Oru-star/Doomsday-deck/Asstets/cooler-40x40x10-1.snapshot.2/untitled.66.jpg

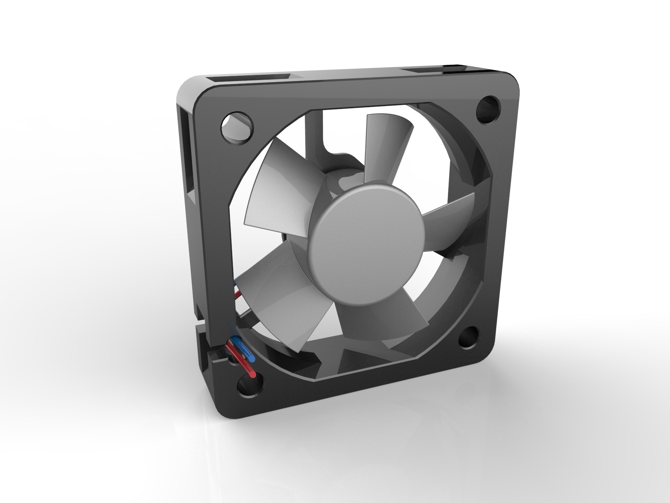
Asstets/cooler-40x40x10-1.snapshot.2/untitled.66.jpg
