Oru-star/Doomsday-deck/Asstets/cooler-40x40x10-1.snapshot.2/untitled.95.jpg

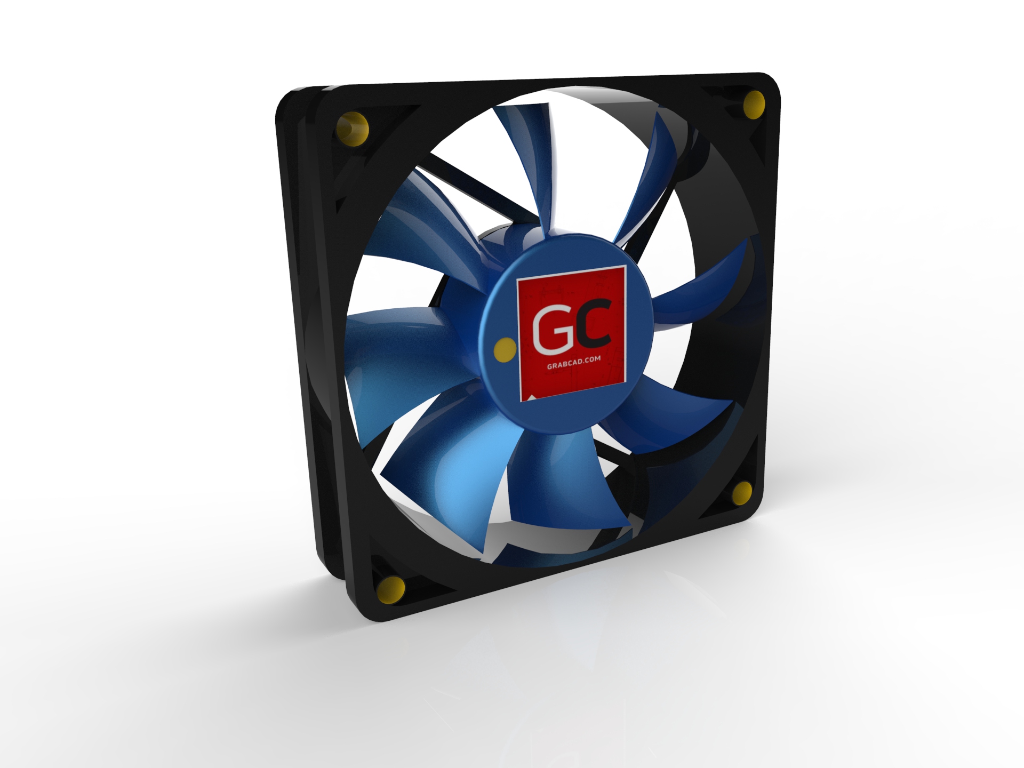
Asstets/cooler-40x40x10-1.snapshot.2/untitled.95.jpg
