Oru-star/Doomsday-deck/Asstets/pin-header-female-2-20-2-54mm-1.snapshot.1/pin header 2x20 2.54mm screen shot.png

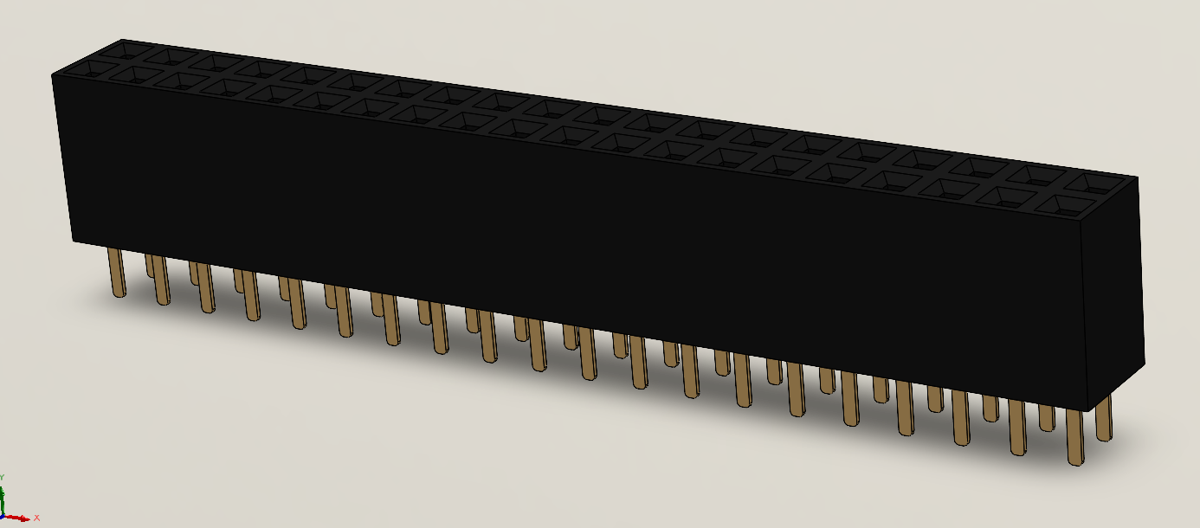
Asstets/pin-header-female-2-20-2-54mm-1.snapshot.1/pin header 2x20 2.54mm screen shot.png
