Oru-star/Doomsday-deck/Asstets/rtl-sdr-ver-3-1.snapshot.8/RTL_SDR-V3_bottom.png

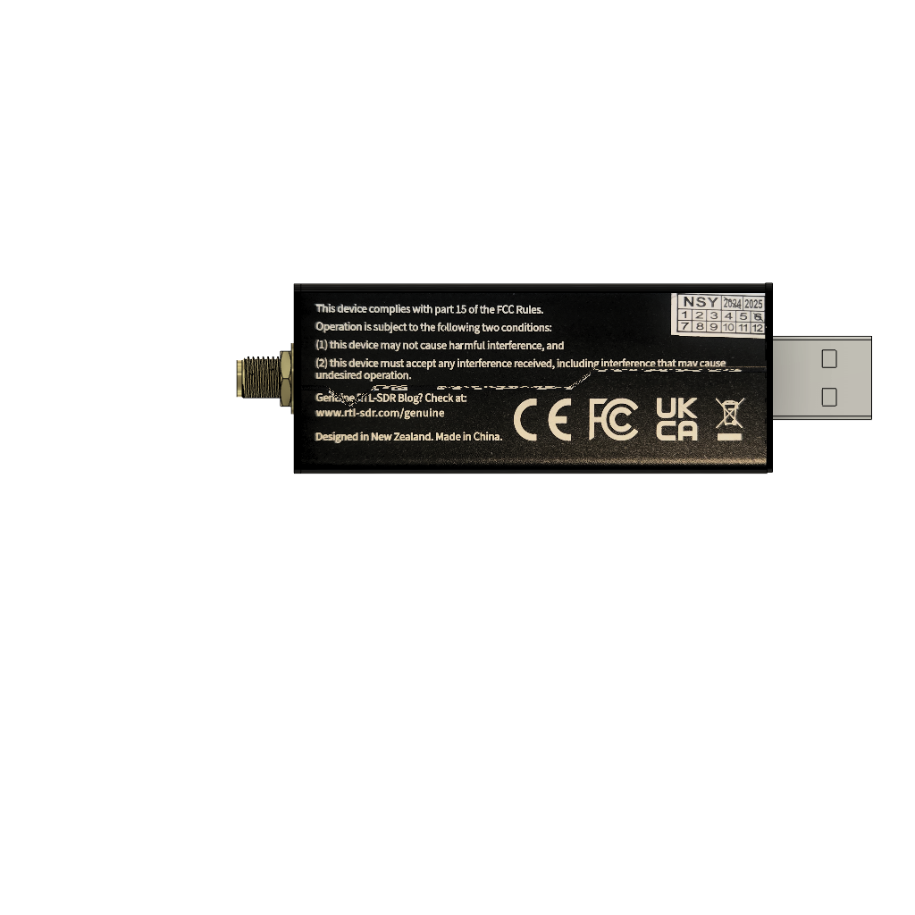
Asstets/rtl-sdr-ver-3-1.snapshot.8/RTL_SDR-V3_bottom.png
