Oru-star/Doomsday-deck/Asstets/rtl-sdr-ver-3-1.snapshot.8/RTL_SDR-V3_left.png

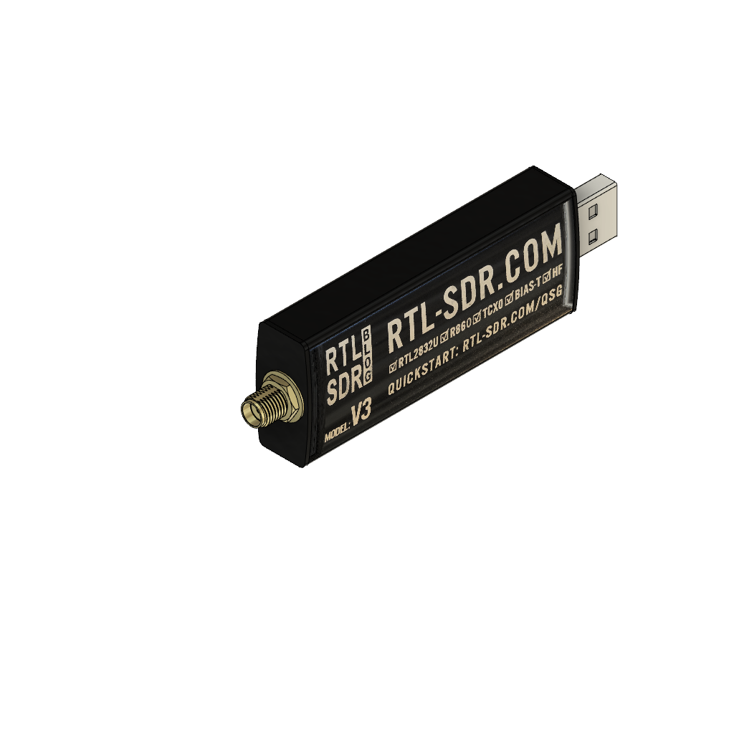
Asstets/rtl-sdr-ver-3-1.snapshot.8/RTL_SDR-V3_left.png
