Oru-star/Doomsday-deck/Asstets/rtl-sdr-ver-3-1.snapshot.8/RTL_SDR_ortho.png

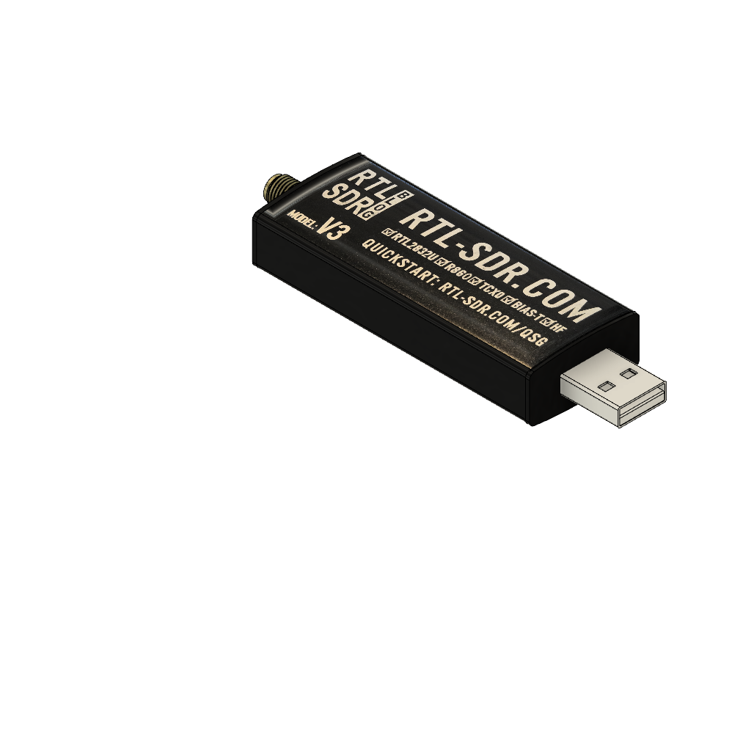
Asstets/rtl-sdr-ver-3-1.snapshot.8/RTL_SDR_ortho.png
