Oru-star/Doomsday-deck/Asstets/usb-typ-a-female-wuerth-629104190121-1.snapshot.1/USB_Type_A_-_Female_-_Würth___629104190121_2021-May-03_12-08-54PM-000_CustomizedView10317502424_png.png

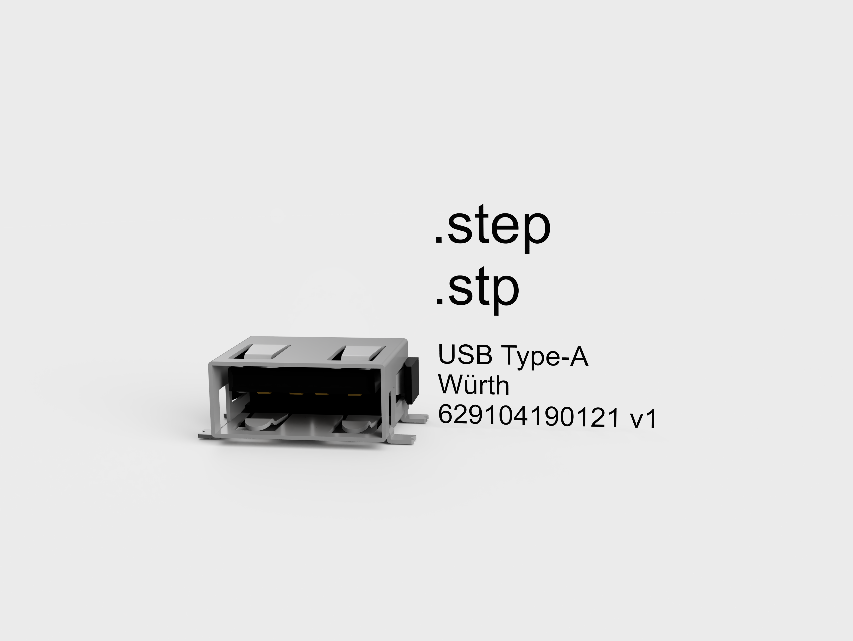
Asstets/usb-typ-a-female-wuerth-629104190121-1.snapshot.1/USB_Type_A_-_Female_-_Würth___629104190121_2021-May-03_12-08-54PM-000_CustomizedView10317502424_png.png
