Oru-star/Doomsday-deck/IMAGES/78b79957-672b-4fc0-9b4d-2bc85868780d.TIFF

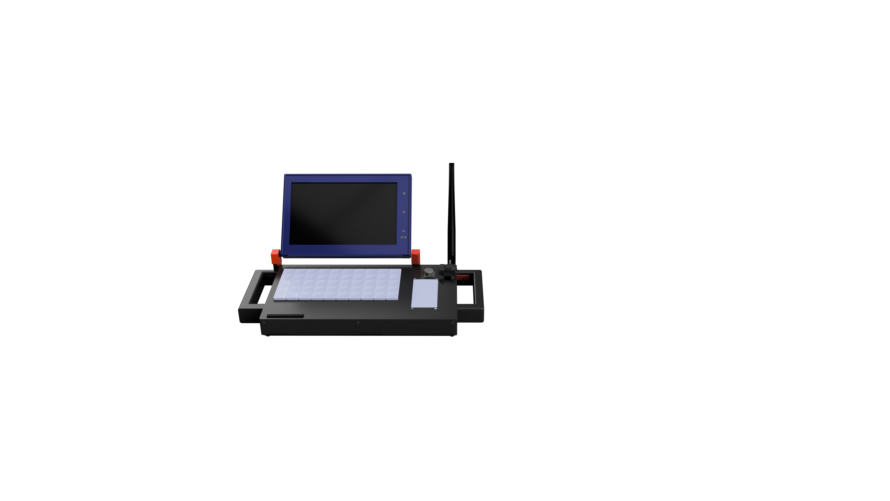
IMAGES/78b79957-672b-4fc0-9b4d-2bc85868780d.TIFF
