Oru-star/Doomsday-deck/IMAGES/BACK-RENDER.TIFF

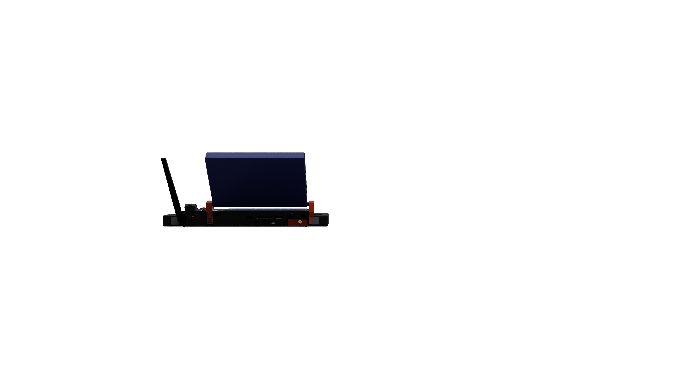
IMAGES/BACK-RENDER.TIFF
