Oru-star/Doomsday-deck/3Dprints for deck/Covers,hinge etc/Left speaker cover.stl

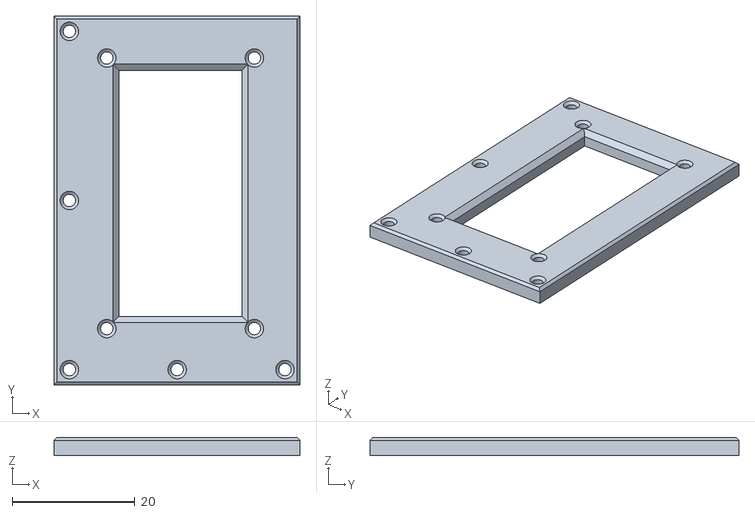
[picture p21: CAD file, 2026-11-02]
3Dprints for deck/Covers,hinge etc/Left speaker cover.stl
40.0 x 60.0 x 3.00
