Oru-star/Doomsday-deck/3Dprints for deck/MAIN DECK/Doomsday Deck-Top plate(Right).stl

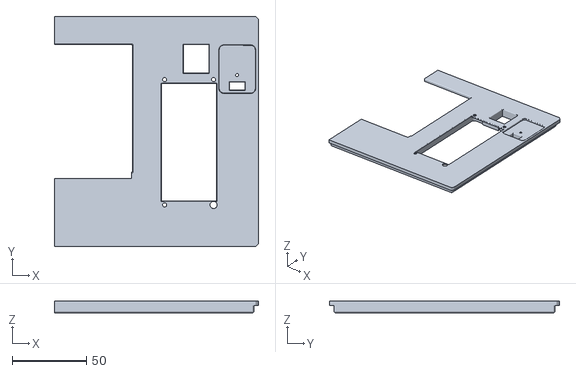
[picture p22: CAD file, 2026-11-02]
3Dprints for deck/MAIN DECK/Doomsday Deck-Top plate(Right).stl
137.5 x 155.0 x 8.00
