Oru-star/Doomsday-deck/3Dprints for deck/SCREEN PART/Bottom_bezzel.stl

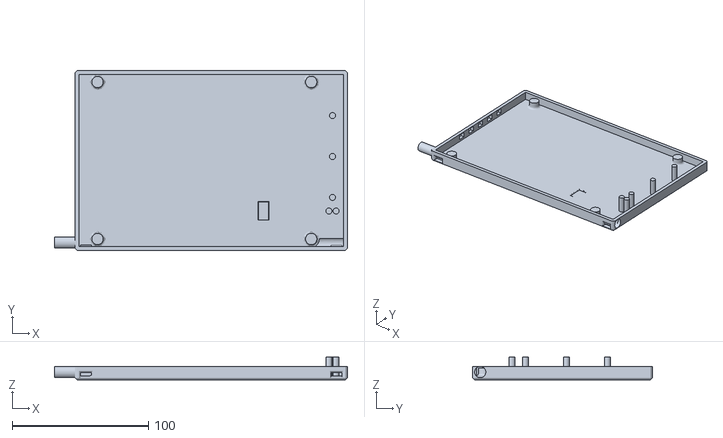
[picture p23: CAD file, 2026-11-02]
3Dprints for deck/SCREEN PART/Bottom_bezzel.stl
215.0 x 132.0 x 16.8
