Oru-star/Doomsday-deck/Asstets/antenna-868-mhz-5dbi-sma-1.snapshot.3/Antenna 868mhz 5dbi 45dg.step

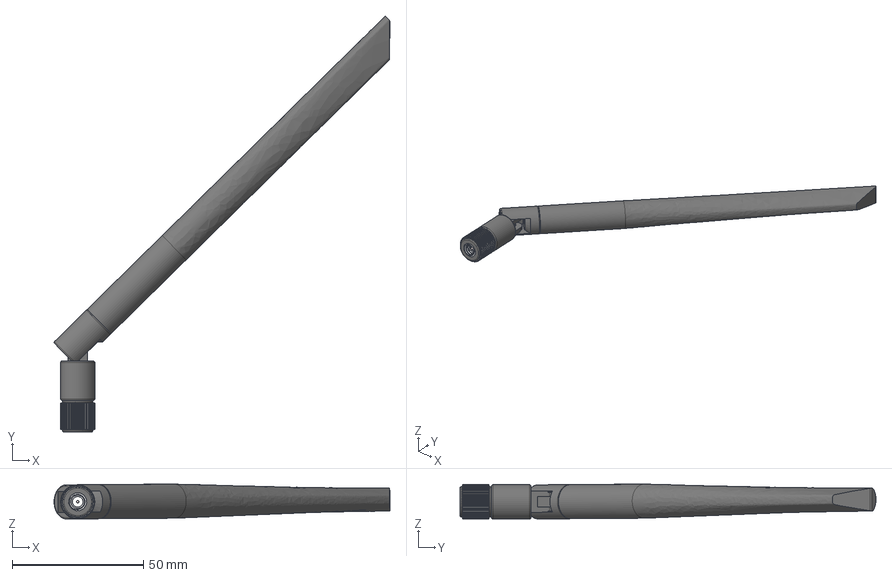
[picture p24: CAD file, 2026-10-02]
Asstets/antenna-868-mhz-5dbi-sma-1.snapshot.3/Antenna 868mhz 5dbi 45dg.step
127.7 x 158.2 x 13.3 mm
SMA sleeve
SMA
Sleeve yoke
emitter yoke
emitter tube
emitter cover
