Oru-star/Doomsday-deck/Asstets/cooler-40x40x10-1.snapshot.2/╨║╤â╨╗╨╡╤Ç 40╤à40╤à10.STEP

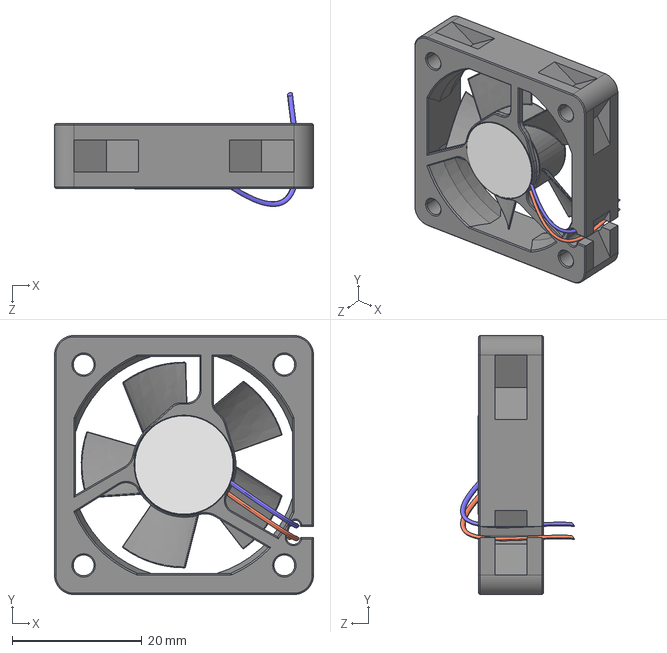
[picture p25: CAD file, 2026-10-10]
Asstets/cooler-40x40x10-1.snapshot.2/╨║╤â╨╗╨╡╤Ç 40╤à40╤à10.STEP
40.0 x 40.0 x 17.6 mm
корпус 40х40х10
вентилятор
