Oru-star/Doomsday-deck/Asstets/dxf/OPi ZERO 3W V1_2_BOT.dxf

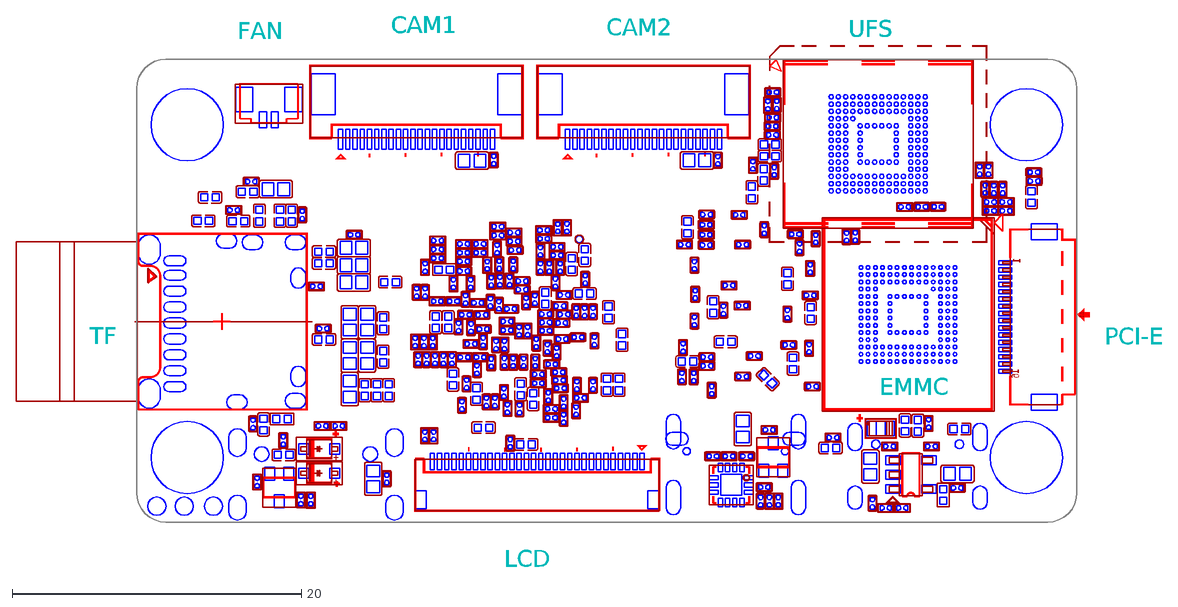
[picture p26: CAD file, 2026-09-23]
Asstets/dxf/OPi ZERO 3W V1_2_BOT.dxf
16
1
FAN
CAM2
CAM1
EMMC
UFS
PCI-E
LCD
TF
