Oru-star/Doomsday-deck/Asstets/Keyboard-Doomsdaydeck.step

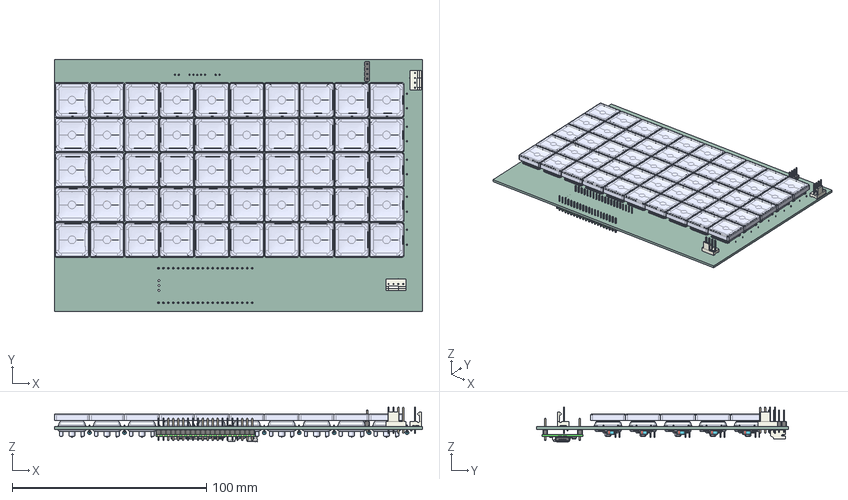
[picture p27: CAD file, 2026-11-02]
Asstets/Keyboard-Doomsdaydeck.step
189.5 x 130.0 x 17.9 mm
Fan_Pin_Header_Straight_1x04 x 2
PinHeader_1x04_P254mm_Vertical
D_DO-35_SOD27_P7.62mm_Horizontal x 50
JST_S2B_PH_K x 2
PinHeader_1x20_P2.54mm_Vertical.step
SMD Resistor, Configurable, Raspberry Pi Pico-R3_R7
U2, RT6150B-33GQW, Buck Boost Converter, Raspberry Pi Pico-R3
SMD Capacitor, Configurable, Raspberry Pi Pico-R3_C3
SMD Resistor, Configurable, Raspberry Pi Pico-R3_R14
SMD Capacitor, Configurable, Raspberry Pi Pico-R3_C12
SMD Resistor, Configurable, Raspberry Pi Pico-R3_R2
SMD Capacitor, Configurable, Raspberry Pi Pico-R3_C13
SMD Resistor, Configurable, Raspberry Pi Pico-R3_R12
U3, W25Q16JVUXIQ, Serial NOR Flash 16 Mbit, Raspberry Pi Pico-R3
SMD Resistor, Configurable, Raspberry Pi Pico-R3_R5
SMD Resistor, Configurable, Raspberry Pi Pico-R3_R1
MicroUSB Port, Raspberry Pi Pico-R3
X1, X12M000000S096, 12 Mhz Crystal Resonator, Raspberry Pi Pico-R3
SMD Capacitor, Configurable, Raspberry Pi Pico-R3_C2
SMD Resistor, Configurable, Raspberry Pi Pico-R3_R4
Q1, MOSFET, DMG1012T, Raspberry Pi Pico-R3
SMD Capacitor, Configurable, Raspberry Pi Pico-R3_C11
SMD Resistor, Configurable, Raspberry Pi Pico-R3_R6
RP2040 Microcontroller, Raspberry Pi Pico-R3
SMD Resistor, Configurable, Raspberry Pi Pico-R3_R9
D1, Diode, Schottky, Raspberry Pi Pico-R3
SMD Resistor, Configurable, Raspberry Pi Pico-R3_R3
SMD Capacitor, Configurable, Raspberry Pi Pico-R3_C8
SMD Capacitor, Configurable, Raspberry Pi Pico-R3_C6
SMD Capacitor, Configurable, Raspberry Pi Pico-R3_C17
SMD Capacitor, Configurable, Raspberry Pi Pico-R3_C16
SMD Capacitor, Configurable, Raspberry Pi Pico-R3_C7
SMD Resistor, Configurable, Raspberry Pi Pico-R3_R11
SMD Capacitor, Configurable, Raspberry Pi Pico-R3_C4
D2, QSME-C194, LED, Raspberry Pi Pico-R3
SMD Capacitor, Configurable, Raspberry Pi Pico-R3_C14
SMD Resistor, Configurable, Raspberry Pi Pico-R3_R8
SW1, Tact Switch, Raspberry Pi Pico-R3
SMD Capacitor, Configurable, Raspberry Pi Pico-R3_C9
SMD Resistor, Configurable, Raspberry Pi Pico-R3_R15
SMD Capacitor, Configurable, Raspberry Pi Pico-R3_C5
SMD Resistor, Configurable, Raspberry Pi Pico-R3_R13
SMD Resistor, Configurable, Raspberry Pi Pico-R3_R10
SMD Capacitor, Configurable, Raspberry Pi Pico-R3_C10
L1, Inductor, Raspberry Pi Pico-R3
PCB, Raspberry Pi Pico-R3
SMD Capacitor, Configurable, Raspberry Pi Pico-R3_C1
SMD Capacitor, Configurable, Raspberry Pi Pico-R3_C15
SMD Capacitor, Configurable, Raspberry Pi Pico-R3_C18
JST_S5B_PH_K
Key1B59_PCB
