Oru-star/Doomsday-deck/Asstets/LIB_USB2517I-JZX/USB2517I-JZX/3D/USB2517I-JZX.stp

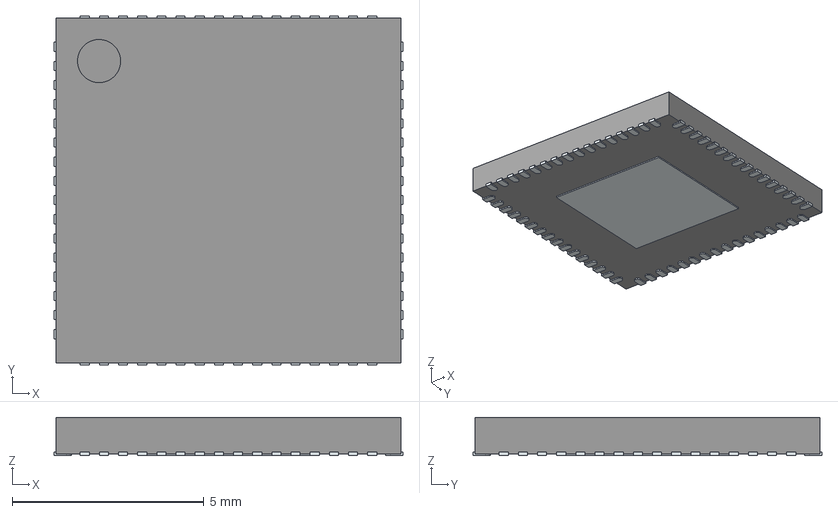
[picture p28: CAD file, 2026-09-23]
Asstets/LIB_USB2517I-JZX/USB2517I-JZX/3D/USB2517I-JZX.stp
9.10 x 9.10 x 1.00 mm
ThermalPin
PinsArrayLR
PinsArrayTB
