Oru-star/Doomsday-deck/Asstets/Model/CapTFT_V2.3mf

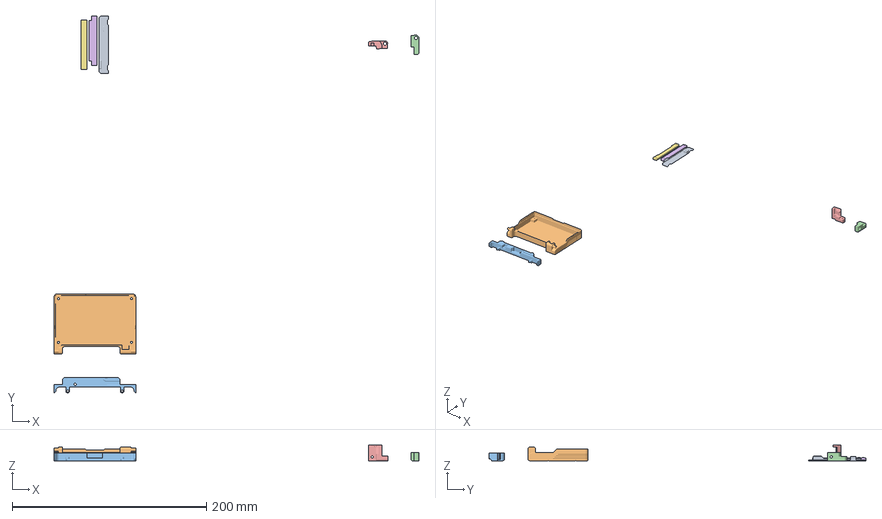
[picture p29: CAD file, 2026-10-02]
Asstets/Model/CapTFT_V2.3mf
375.2 x 387.8 x 16.0 mm
CaseC1.stl
CaseD1.stl
CaseS1.stl
CaseL1.stl
CaseR1.stl
CaseD3.stl
CaseD2.stl
