Oru-star/Doomsday-deck/Asstets/Model/STL/CaseS1.stl

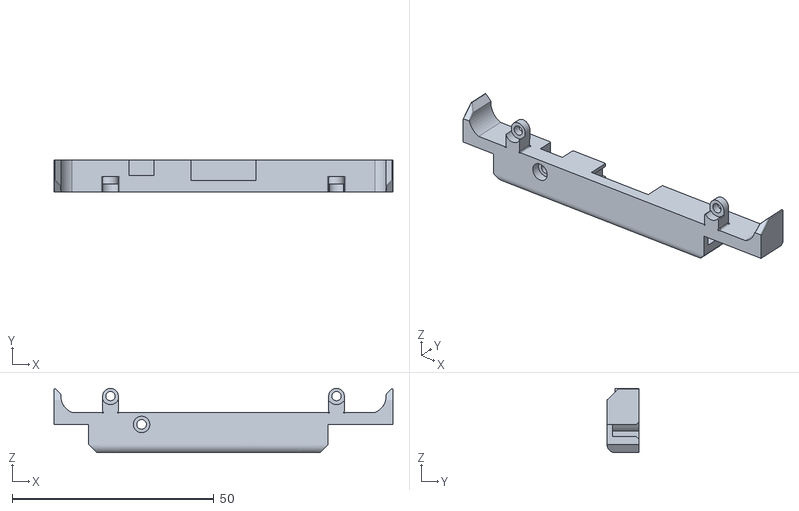
[picture p30: CAD file, 2026-10-02]
Asstets/Model/STL/CaseS1.stl
84.0 x 7.90 x 16.0
