Oru-star/Doomsday-deck/Asstets/pin-header-female-2-20-2-54mm-1.snapshot.1/Header 2x20 2.54mm.SLDPRT

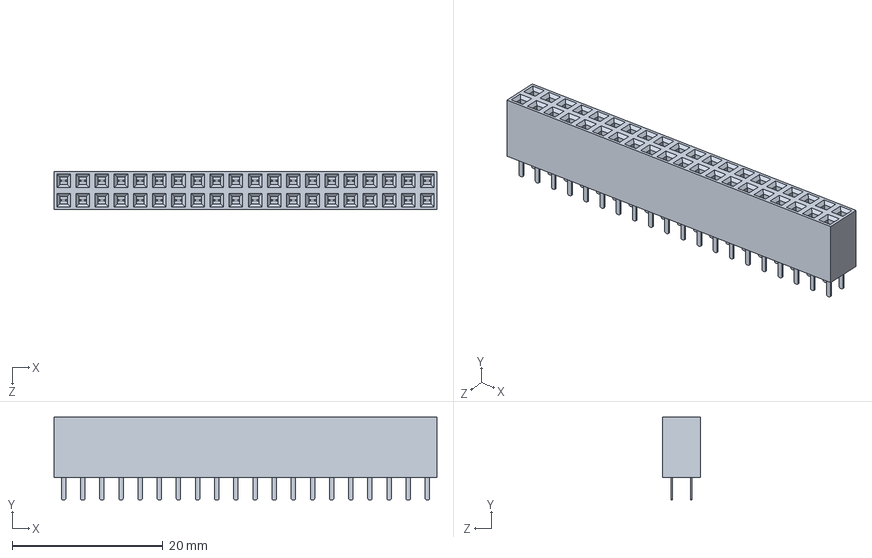
[picture p31: CAD file, 2026-10-10]
Asstets/pin-header-female-2-20-2-54mm-1.snapshot.1/Header 2x20 2.54mm.SLDPRT
50.8 x 11.0 x 5.08 mm
