Oru-star/Doomsday-deck/Asstets/rtl-sdr-ver-3-1.snapshot.8/RTL_SDR-V3.step

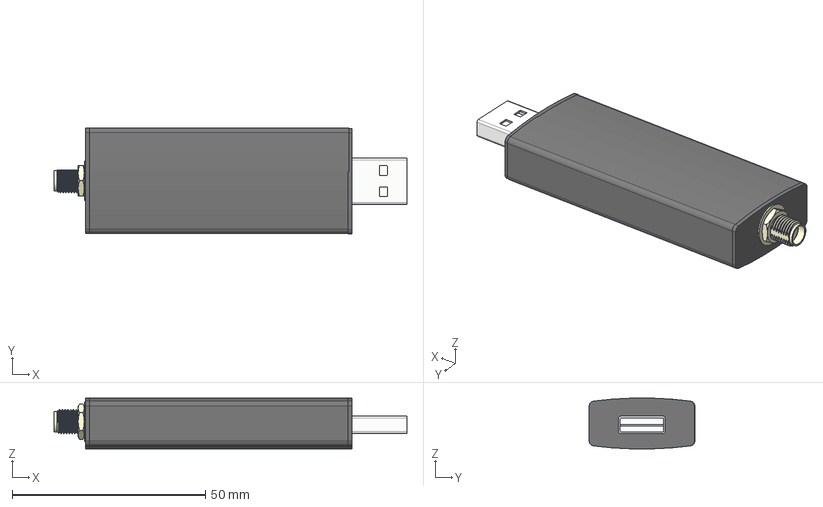
[picture p32: CAD file, 2026-09-23]
Asstets/rtl-sdr-ver-3-1.snapshot.8/RTL_SDR-V3.step
91.2 x 27.3 x 13.1 mm
main_body
face_sma
sma_jack
face_usb
