Oru-star/Doomsday-deck/Asstets/sma-antenna-connector-2.snapshot.3/Connector_Ass_Step.STEP

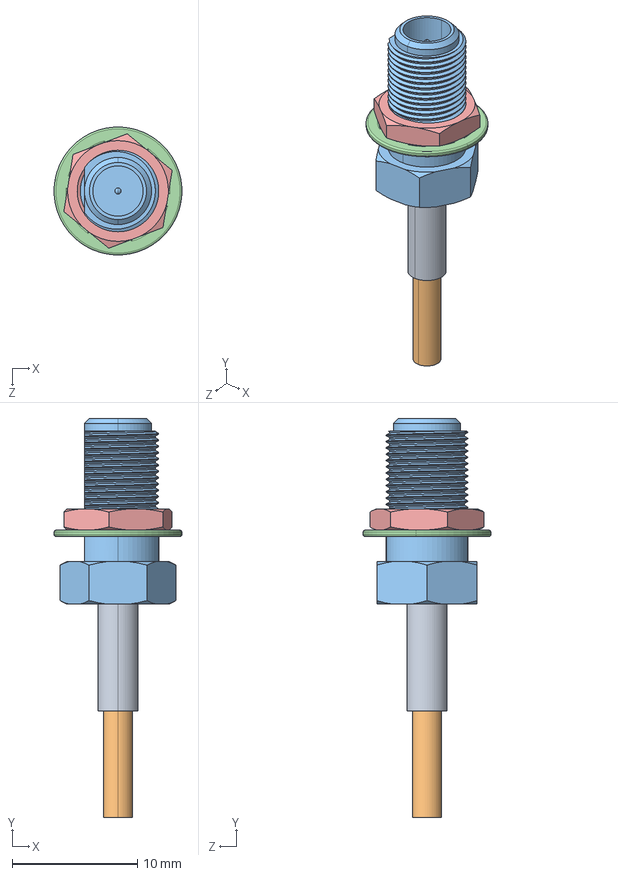
[picture p33: CAD file, 2026-10-02]
Asstets/sma-antenna-connector-2.snapshot.3/Connector_Ass_Step.STEP
10.2 x 31.8 x 10.2 mm
Connector_2
Washer
Nut
