Oru-star/Doomsday-deck/Asstets/usb-typ-a-female-wuerth-629104190121-1.snapshot.1/USB Type A - Female - Würth _ 629104190121.step

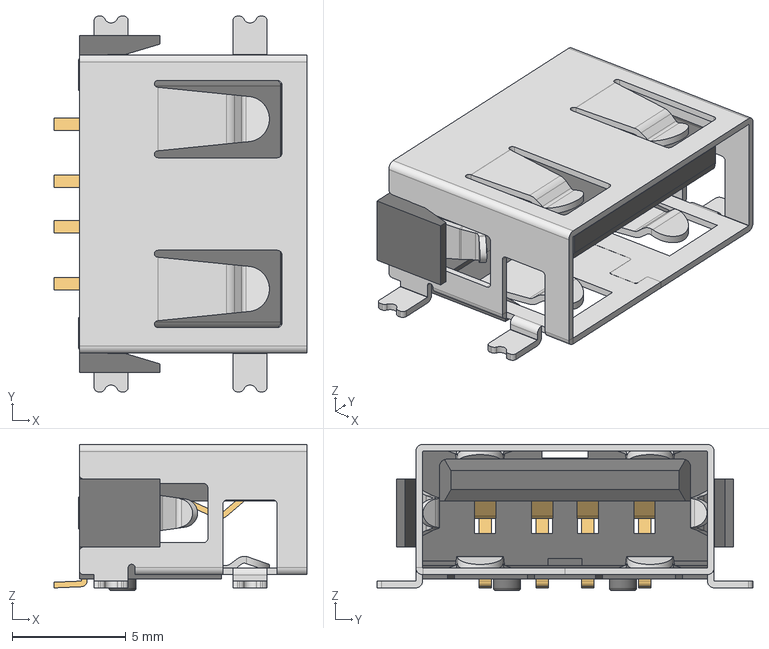
[picture p34: CAD file, 2026-09-26]
Asstets/usb-typ-a-female-wuerth-629104190121-1.snapshot.1/USB Type A - Female - Würth _ 629104190121.step
11.1 x 16.5 x 6.42 mm
