Oru-star/Doomsday-deck/carrier-orange pi zero 3w/step's n render's/Base-parts/RTL_COVER.step

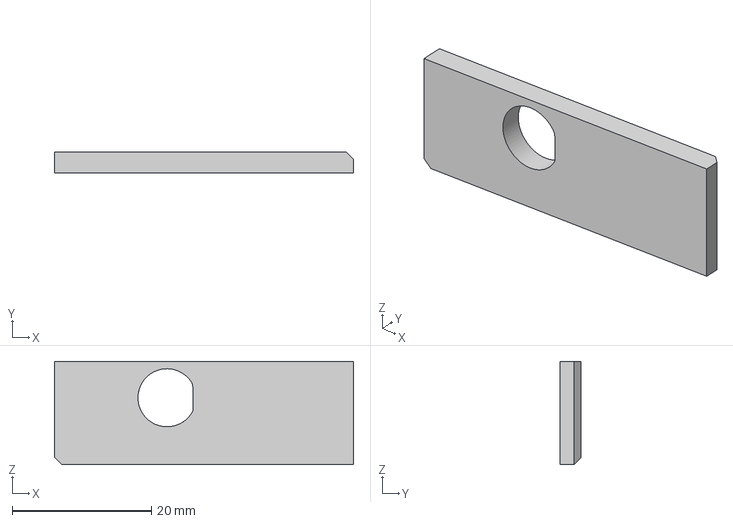
[picture p35: CAD file, 2026-10-10]
carrier-orange pi zero 3w/step's n render's/Base-parts/RTL_COVER.step
43.0 x 3.00 x 14.8 mm
