Oru-star/Doomsday-deck/PCB'S/KEYBOARD'S PCB/KEYBOARD ASSETS/kailh-low-profile-keycaps-1.snapshot.2/Kailh LP Keycap.SLDPRT

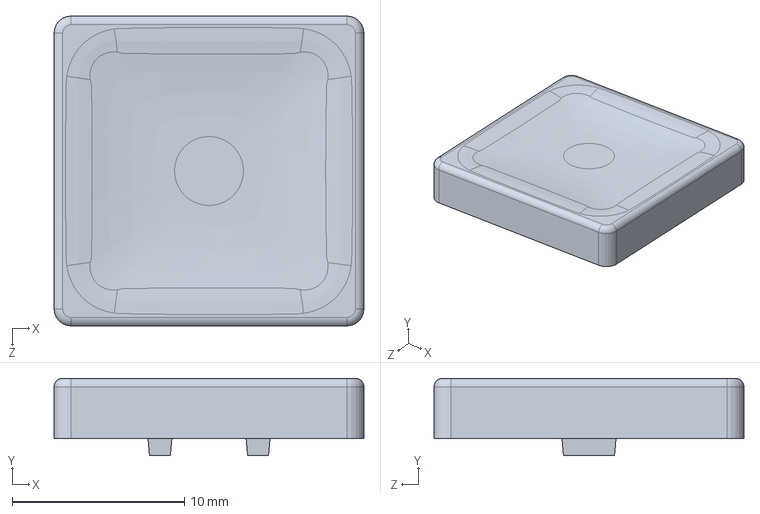
[picture p36: CAD file, 2026-09-23]
PCB'S/KEYBOARD'S PCB/KEYBOARD ASSETS/kailh-low-profile-keycaps-1.snapshot.2/Kailh LP Keycap.SLDPRT
18.0 x 4.50 x 18.0 mm
