Oru-star/Doomsday-deck/PCB'S/KEYBOARD'S PCB/KEYBOARD ASSETS/kailh-low-profile-keycaps-1.snapshot.2/KailhLP Choc Keycap STEP/1x1.75.STEP

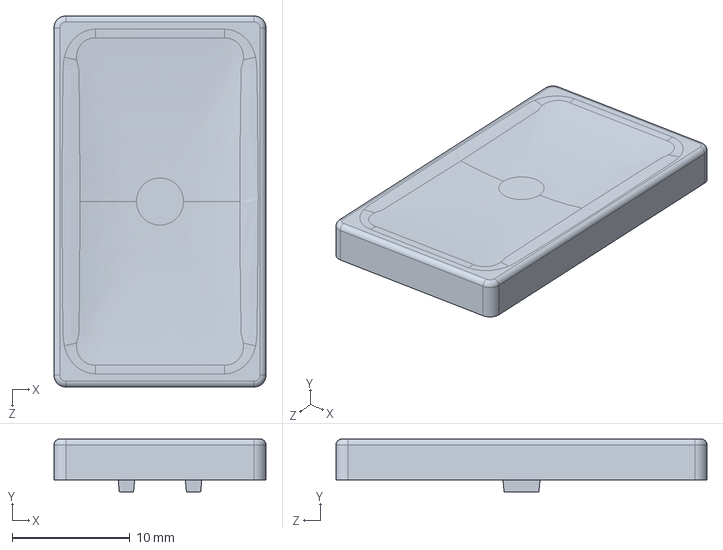
[picture p37: CAD file, 2026-09-23]
PCB'S/KEYBOARD'S PCB/KEYBOARD ASSETS/kailh-low-profile-keycaps-1.snapshot.2/KailhLP Choc Keycap STEP/1x1.75.STEP
18.0 x 4.50 x 31.5 mm
