Oru-star/Doomsday-deck/PCB'S/KEYBOARD'S PCB/KEYBOARD ASSETS/kailh-low-profile-mechanical-keyboard-switch-1.snapshot.1/Kailh LP Choc Burnt Orange.STEP

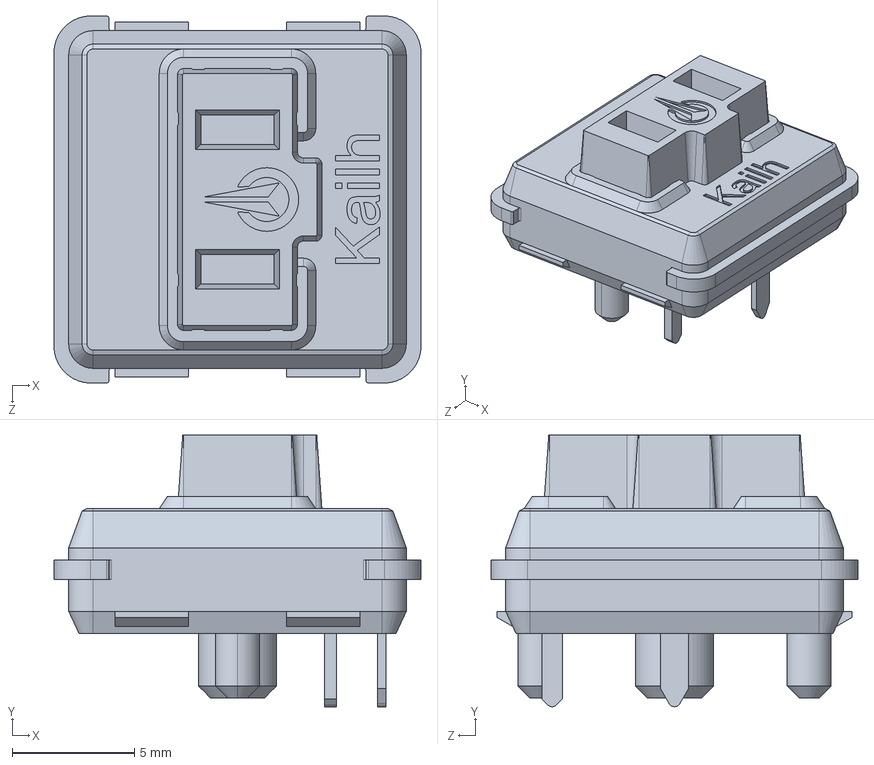
[picture p38: CAD file, 2026-09-23]
PCB'S/KEYBOARD'S PCB/KEYBOARD ASSETS/kailh-low-profile-mechanical-keyboard-switch-1.snapshot.1/Kailh LP Choc Burnt Orange.STEP
15.0 x 11.1 x 15.0 mm
