Oru-star/Doomsday-deck/PCB'S/KEYBOARD'S PCB/KEYBOARD ASSETS/seeed-studio-xiao-rp2040-3d-model/Seeed Studio XIAO RP2040 v26.step

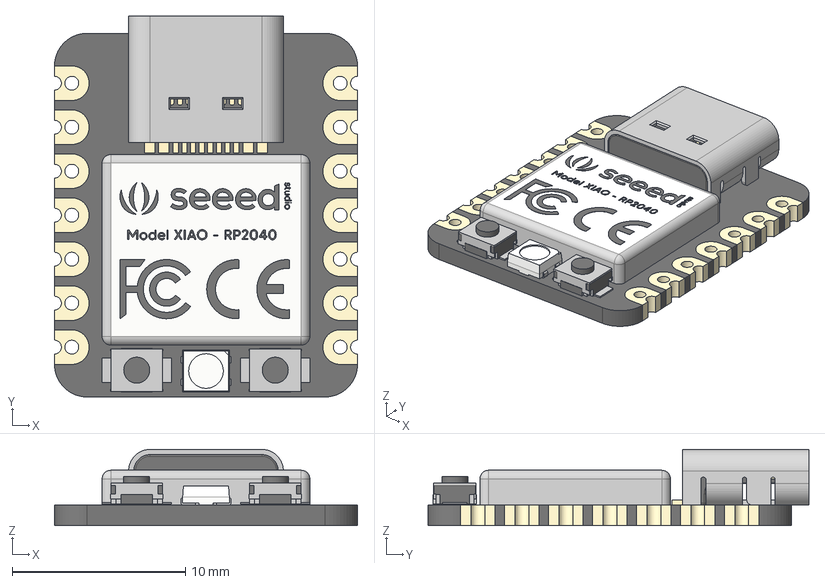
[picture p39: CAD file, 2026-09-23]
PCB'S/KEYBOARD'S PCB/KEYBOARD ASSETS/seeed-studio-xiao-rp2040-3d-model/Seeed Studio XIAO RP2040 v26.step
17.5 x 22.0 x 4.40 mm
type-c v2
smd_button v3
DOUT
DIN
VSS
VDD
smd_button v3(Mirror)
