Oru-star/Doomsday-deck/step's n render's/DECK-BASE/BASE.step

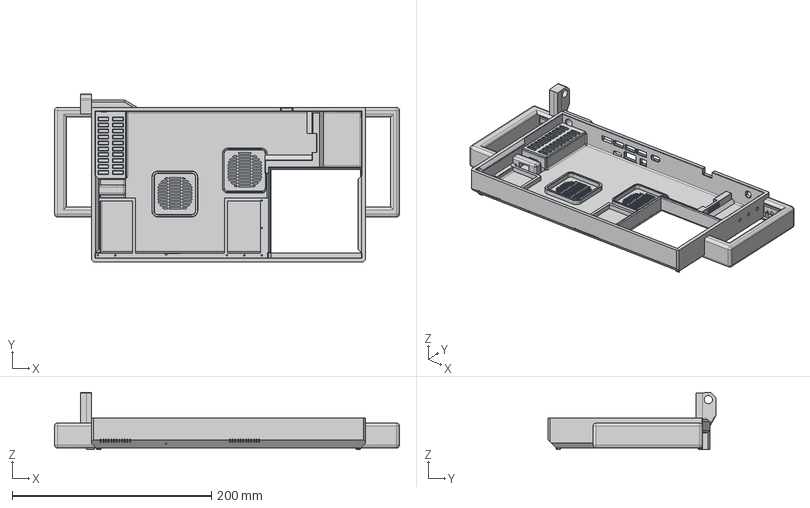
[picture p40: CAD file, 2026-10-10]
step's n render's/DECK-BASE/BASE.step
346.0 x 168.1 x 57.3 mm
