Oru-star/Doomsday-deck/step's n render's/DECK-TOP/TOP_PANNEL.step

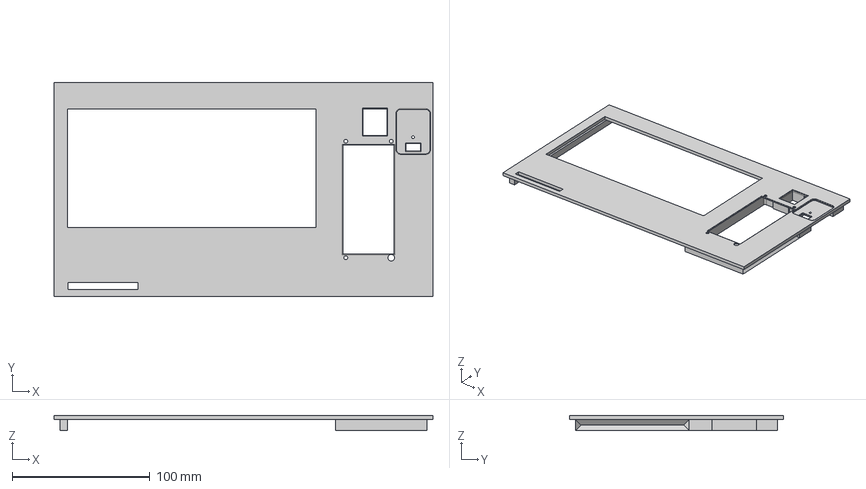
[picture p41: CAD file, 2026-10-10]
step's n render's/DECK-TOP/TOP_PANNEL.step
275.0 x 155.0 x 11.0 mm
