Oru-star/Doomsday-deck/step's n render's/DISPLAY-TOP/TOP_BEZZEL.step

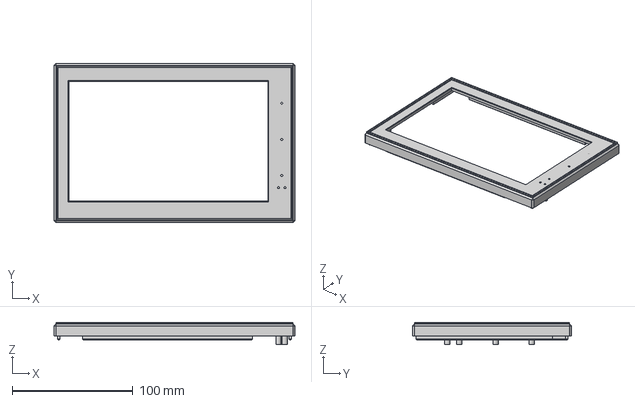
[picture p42: CAD file, 2026-10-10]
step's n render's/DISPLAY-TOP/TOP_BEZZEL.step
200.0 x 132.0 x 18.5 mm
