Oru-star/Doomsday-deck/3Dprints for deck/MAIN DECK/RIGHT_SIDE OF DECK.stl

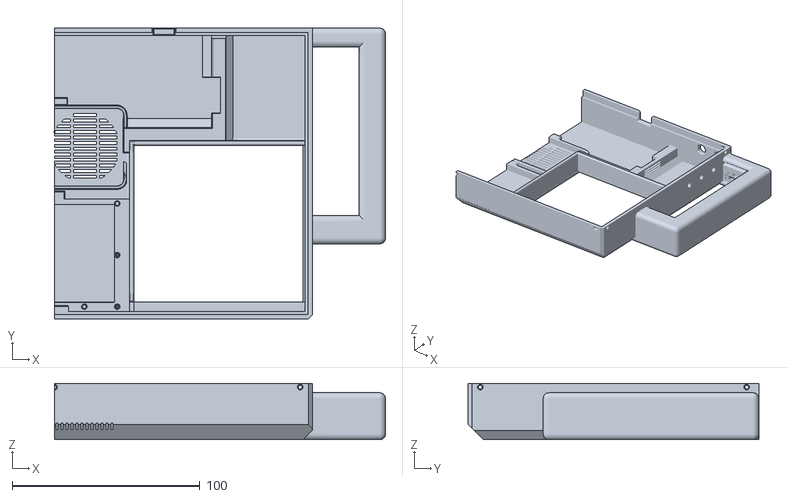
[picture p43: CAD file, 2026-11-02]
3Dprints for deck/MAIN DECK/RIGHT_SIDE OF DECK.stl
176.5 x 155.0 x 30.0
