Oru-star/Doomsday-deck/3Dprints for deck/SCREEN PART/top_bezzel.stl

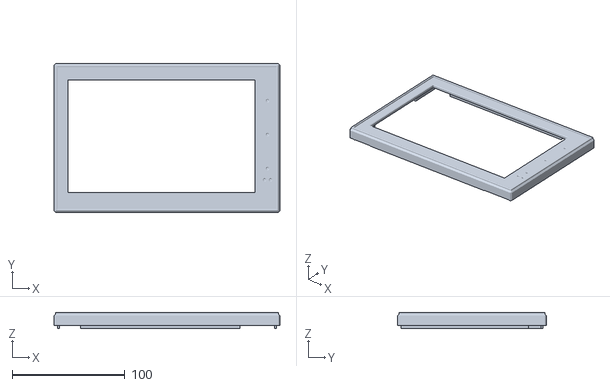
[picture p44: CAD file, 2026-11-02]
3Dprints for deck/SCREEN PART/top_bezzel.stl
200.0 x 132.0 x 14.5
