Oru-star/Doomsday-deck/Asstets/antenna-868-mhz-5dbi-sma-1.snapshot.3/Antenna 868mhz 5dbi 90dg.step

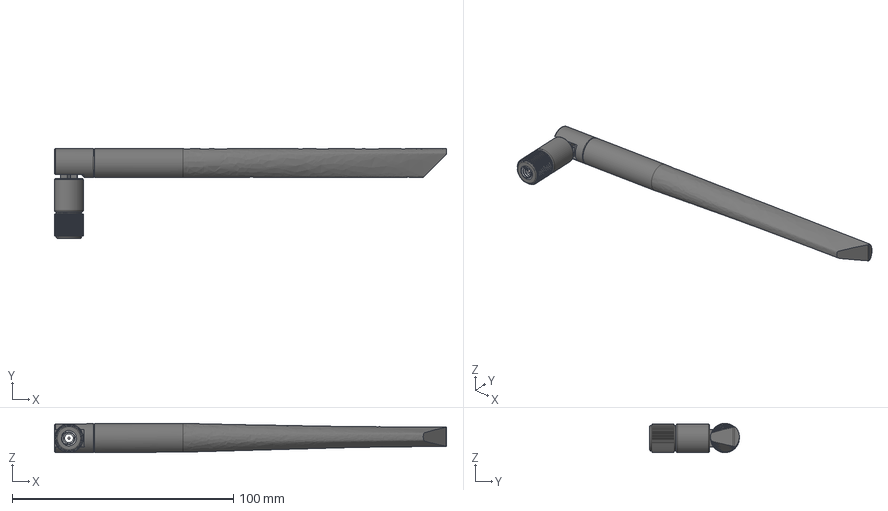
[picture p45: CAD file, 2026-10-02]
Asstets/antenna-868-mhz-5dbi-sma-1.snapshot.3/Antenna 868mhz 5dbi 90dg.step
177.0 x 40.5 x 13.2 mm
SMA sleeve
SMA
Sleeve yoke
emitter yoke
emitter tube
emitter cover
