Oru-star/Doomsday-deck/Asstets/cooler-40x40x10-1.snapshot.2/╨▓╨╡╨╜╤é╨╕╨╗╤Å╤é╨╛╤Ç.SLDPRT

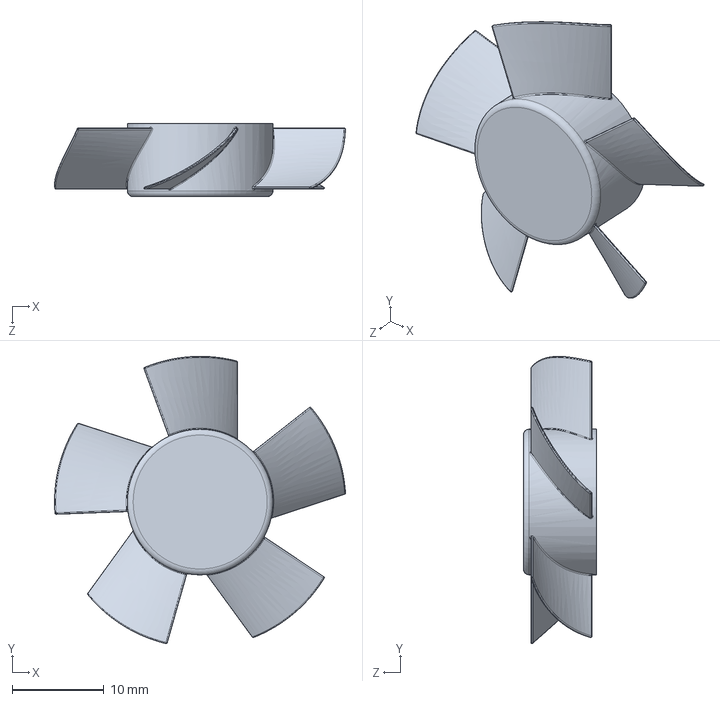
[picture p46: CAD file, 2026-10-10]
Asstets/cooler-40x40x10-1.snapshot.2/╨▓╨╡╨╜╤é╨╕╨╗╤Å╤é╨╛╤Ç.SLDPRT
31.7 x 31.3 x 8.00 mm
