Oru-star/Doomsday-deck/Asstets/dxf/OPi ZERO 3W V1_2_TOP.dxf

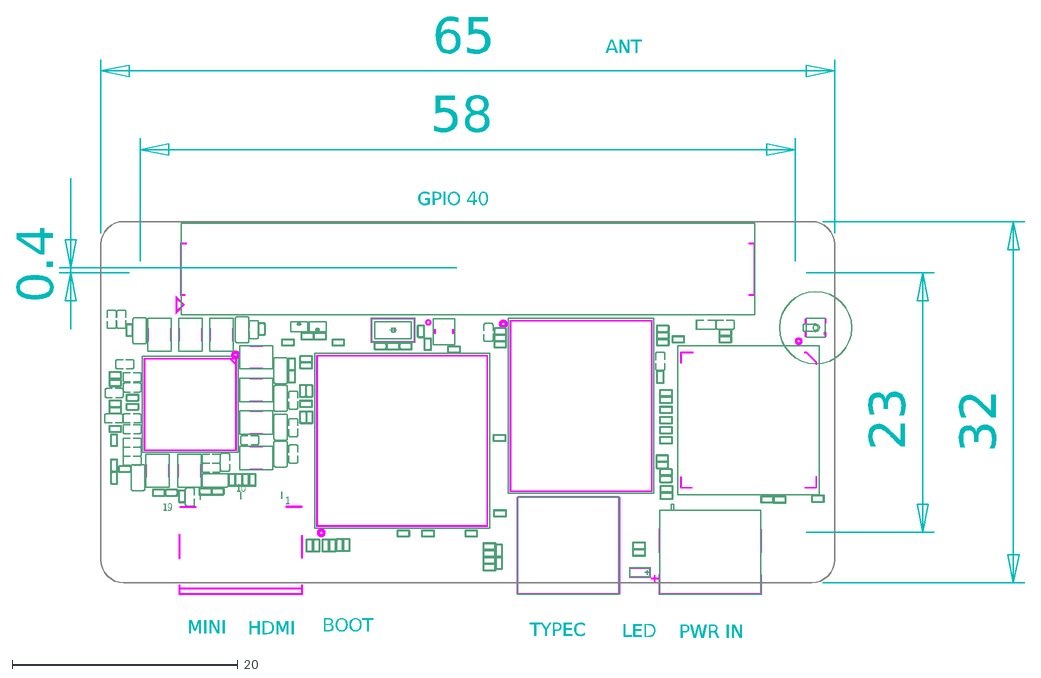
[picture p47: CAD file, 2026-09-23]
Asstets/dxf/OPi ZERO 3W V1_2_TOP.dxf
19
10
1
32
65
23
58
0.4
GPIO 40
ANT
LED
PWR IN
TYPEC
BOOT
HDMI
MINI
