Oru-star/Doomsday-deck/Asstets/Model/STL/CaseL1.stl

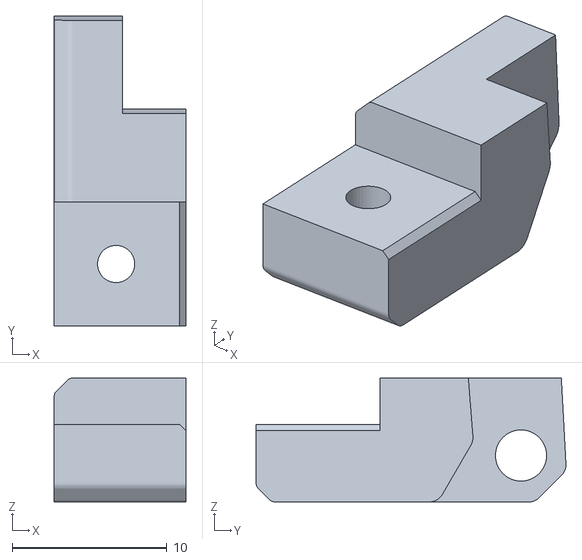
[picture p48: CAD file, 2026-10-02]
Asstets/Model/STL/CaseL1.stl
8.50 x 20.0 x 8.00
