Oru-star/Doomsday-deck/carrier-orange pi zero 3w/step's n render's/Base-parts/battery case.step

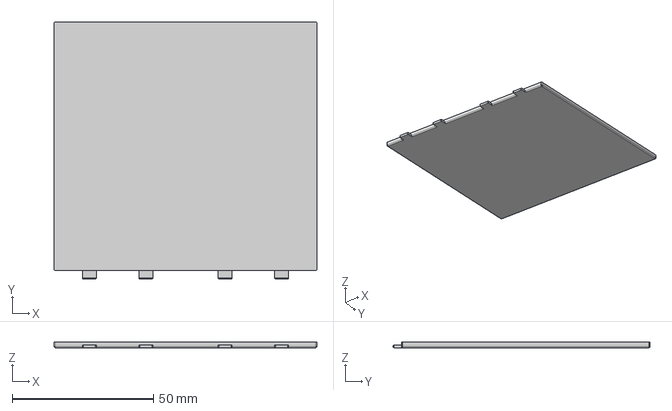
[picture p49: CAD file, 2026-10-10]
carrier-orange pi zero 3w/step's n render's/Base-parts/battery case.step
93.0 x 91.0 x 2.00 mm
