Oru-star/Doomsday-deck/PCB'S/KEYBOARD'S PCB/hackpadd.step

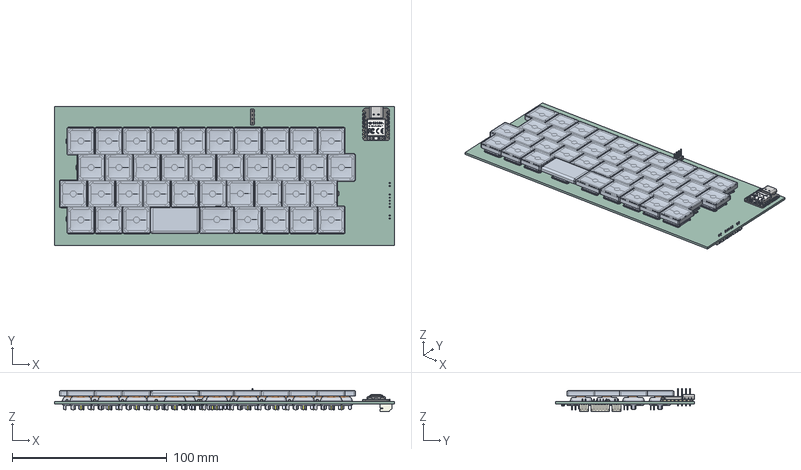
[picture p50: CAD file, 2026-09-24]
PCB'S/KEYBOARD'S PCB/hackpadd.step
220.0 x 90.0 x 15.1 mm
D_SOD-123 x 39
1x1 x 37
type-c v2
smd_button v3
DOUT
DIN
VSS
VDD
smd_button v3(Mirror)
Space
1.25x1
PinHeader_1x04_P254mm_Vertical
JST_S2B_PH_K x 2
R_0805_2012Metric x 3
C_0805_2012Metric
JST_S5B_PH_K
QFN-28-1EP_6x6mm_Pitch0.65mm
Keyboard-Zerodeck_PCB
