Oru-star/Doomsday-deck/step's n render's/BASE/Base-Parts/R_HINGE.step

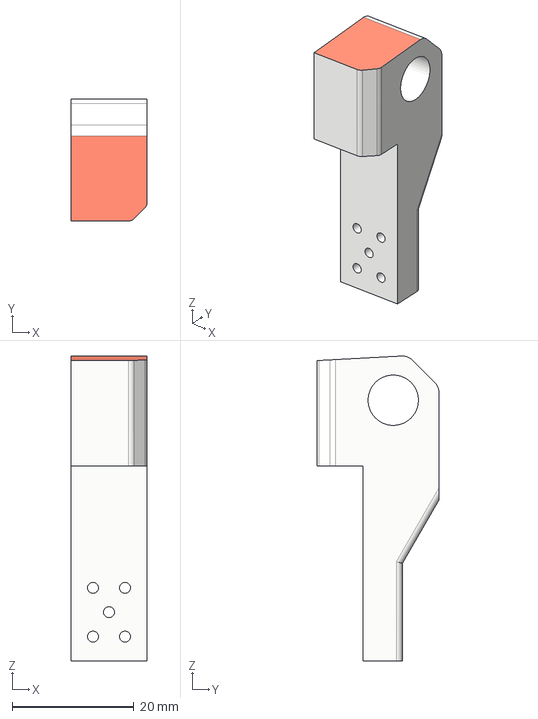
[picture p52: CAD file, 2026-10-10]
step's n render's/BASE/Base-Parts/R_HINGE.step
12.5 x 20.0 x 50.0 mm
