Oru-star/Doomsday-deck/step's n render's/DISPLAY-TOP/BUTTON'S.step

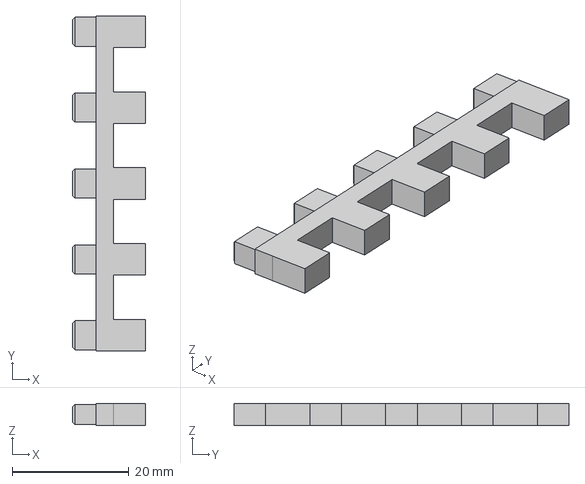
[picture p53: CAD file, 2026-10-10]
step's n render's/DISPLAY-TOP/BUTTON'S.step
12.5 x 57.4 x 3.80 mm
