Oru-star/Doomsday-deck/3Dprints for deck/Covers,hinge etc/Adjustable-Hinge (R).stl

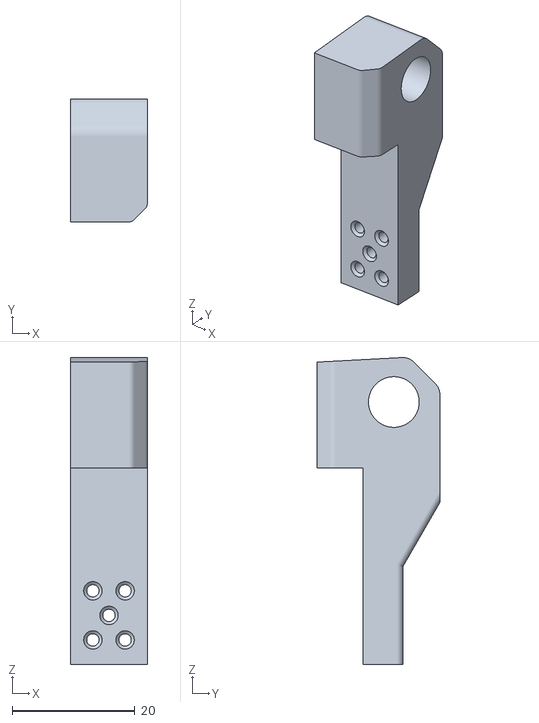
[picture p54: CAD file, 2026-11-02]
3Dprints for deck/Covers,hinge etc/Adjustable-Hinge (R).stl
12.5 x 20.0 x 50.0
