Oru-star/Doomsday-deck/Asstets/Antenna 868mhz 5dbi.step

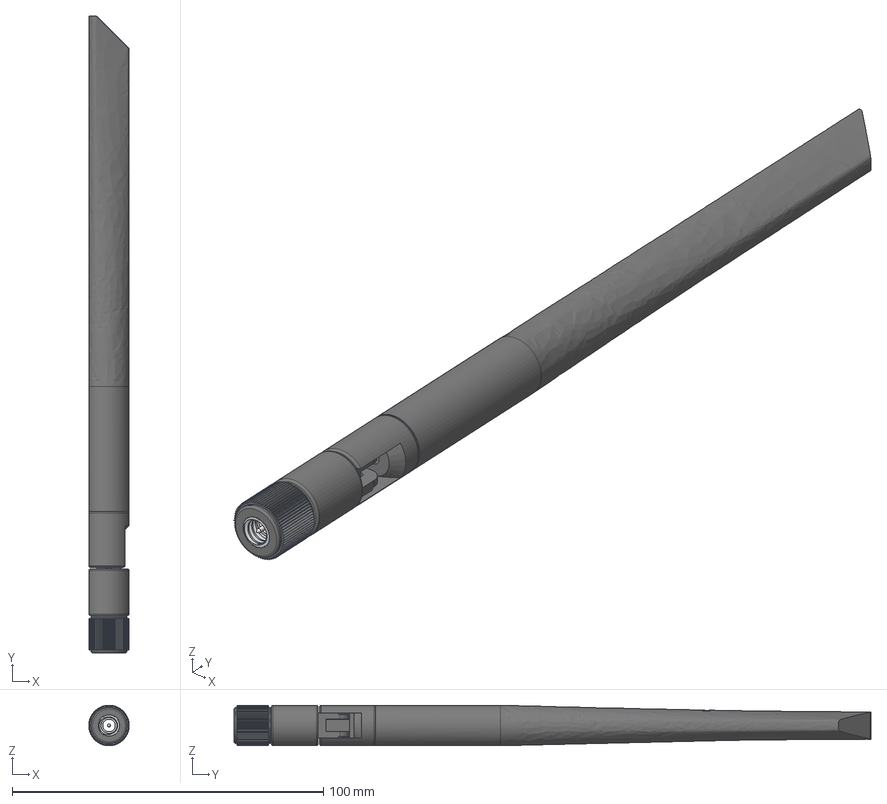
[picture p56: CAD file, 2026-10-02]
Asstets/Antenna 868mhz 5dbi.step
13.0 x 204.5 x 13.0 mm
SMA sleeve
SMA
Sleeve yoke
emitter yoke
emitter tube
emitter cover
