Oru-star/Doomsday-deck/Asstets/cooler-40x40x10-1.snapshot.2/╨║╨╛╤Ç╨┐╤â╤ü 40╤à40╤à10.SLDPRT

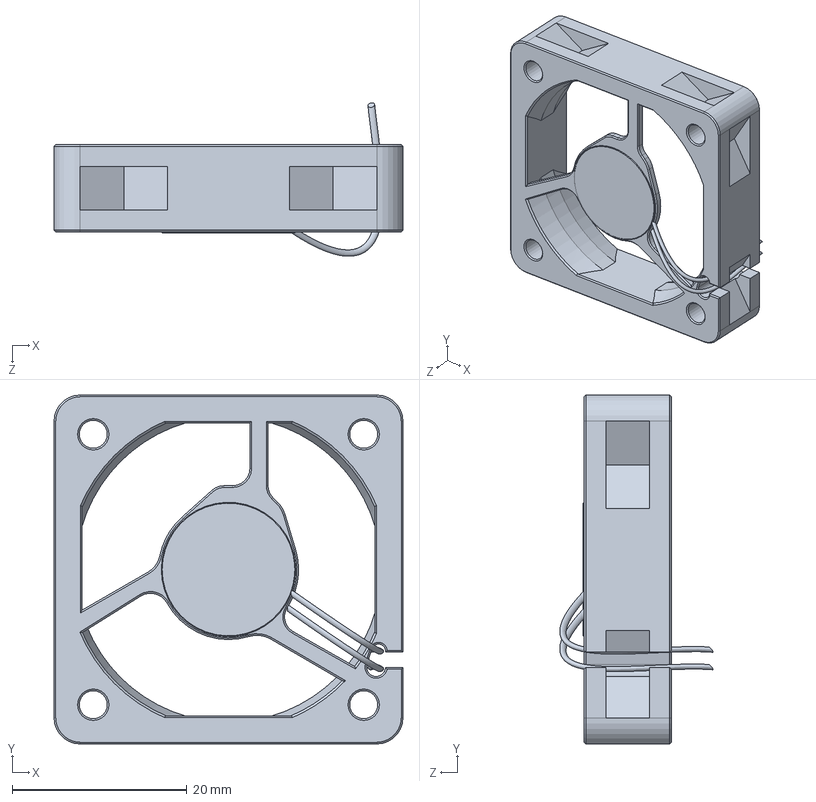
[picture p57: CAD file, 2026-10-10]
Asstets/cooler-40x40x10-1.snapshot.2/╨║╨╛╤Ç╨┐╤â╤ü 40╤à40╤à10.SLDPRT
40.0 x 40.0 x 17.6 mm
