Oru-star/Doomsday-deck/Asstets/Model/STL/CaseD3.stl

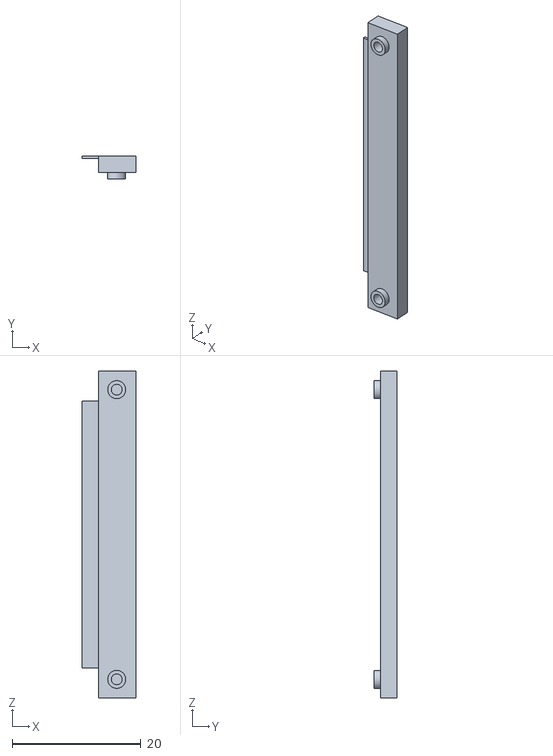
[picture p58: CAD file, 2026-10-02]
Asstets/Model/STL/CaseD3.stl
8.40 x 3.60 x 50.8
