Oru-star/Doomsday-deck/3Dprints for deck/MAIN DECK/LEFT_SIDE OF DECK.stl

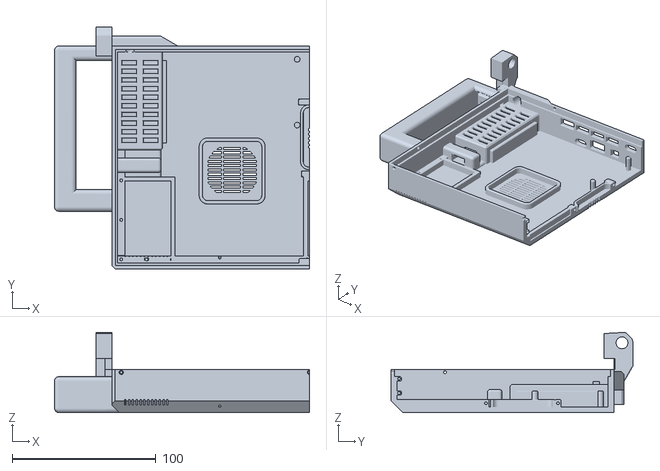
[picture p59: CAD file, 2026-11-02]
3Dprints for deck/MAIN DECK/LEFT_SIDE OF DECK.stl
177.5 x 168.1 x 55.8
