Oru-star/Doomsday-deck/Asstets/DRT0003A.stp

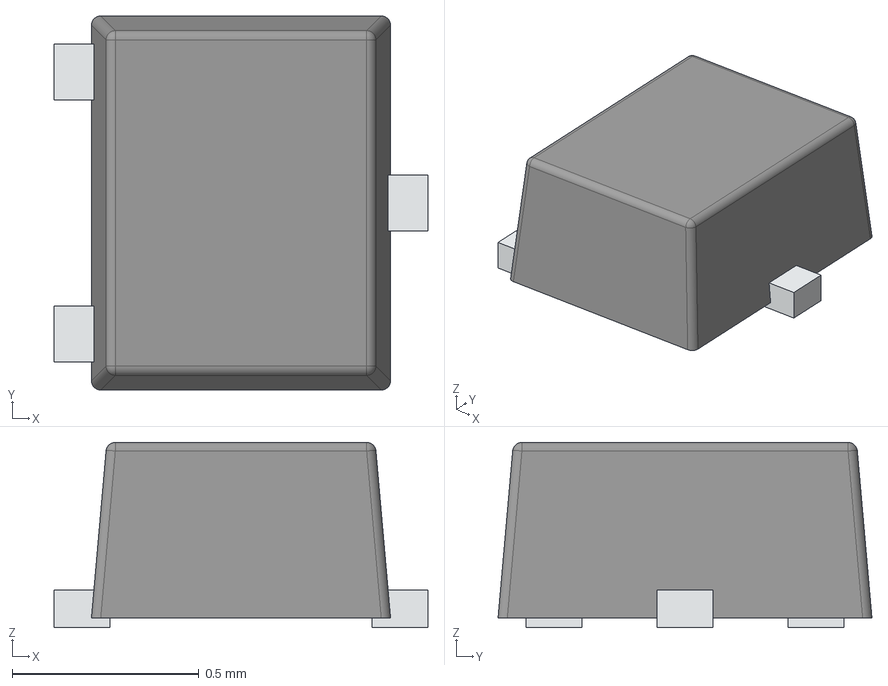
[picture p60: CAD file, 2026-09-23]
Asstets/DRT0003A.stp
1.00 x 1.00 x 0.495 mm
FRAME
