Oru-star/Doomsday-deck/Asstets/Model/STL/CaseD1.stl

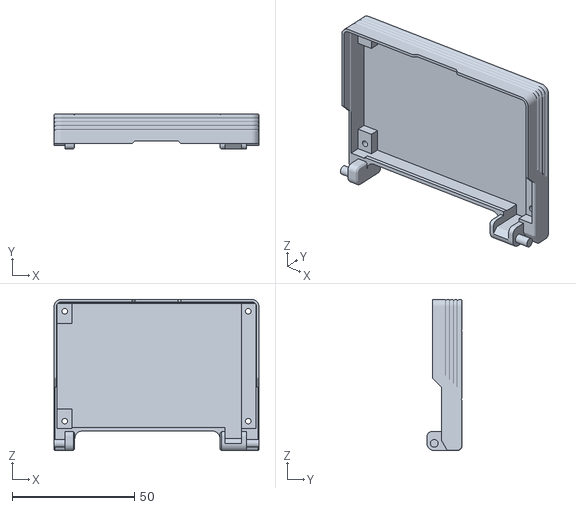
[picture p61: CAD file, 2026-10-02]
Asstets/Model/STL/CaseD1.stl
84.0 x 14.4 x 62.0
