Oru-star/Doomsday-deck/PCB'S/KEYBOARD'S PCB/KEYBOARD ASSETS/kailh-low-profile-keycaps-1.snapshot.2/KailhLP Choc Keycap STEP/1.5x1.STEP

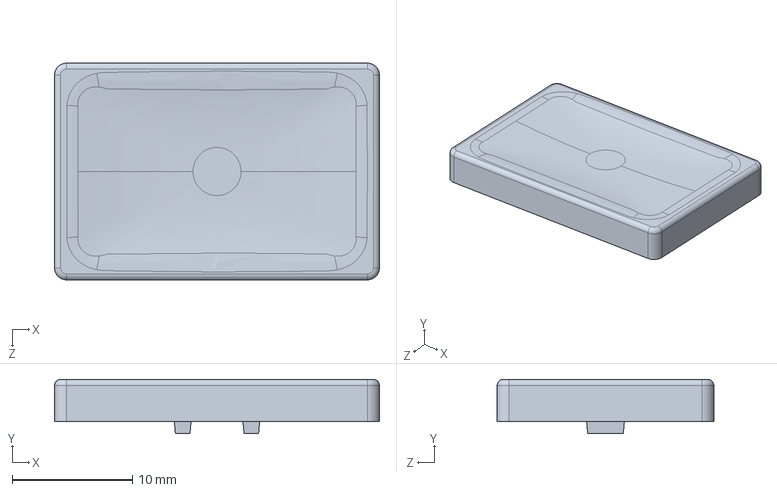
[picture p62: CAD file, 2026-09-23]
PCB'S/KEYBOARD'S PCB/KEYBOARD ASSETS/kailh-low-profile-keycaps-1.snapshot.2/KailhLP Choc Keycap STEP/1.5x1.STEP
27.0 x 4.50 x 18.0 mm
