Oru-star/Doomsday-deck/Asstets/Model/STL/CaseD2.stl

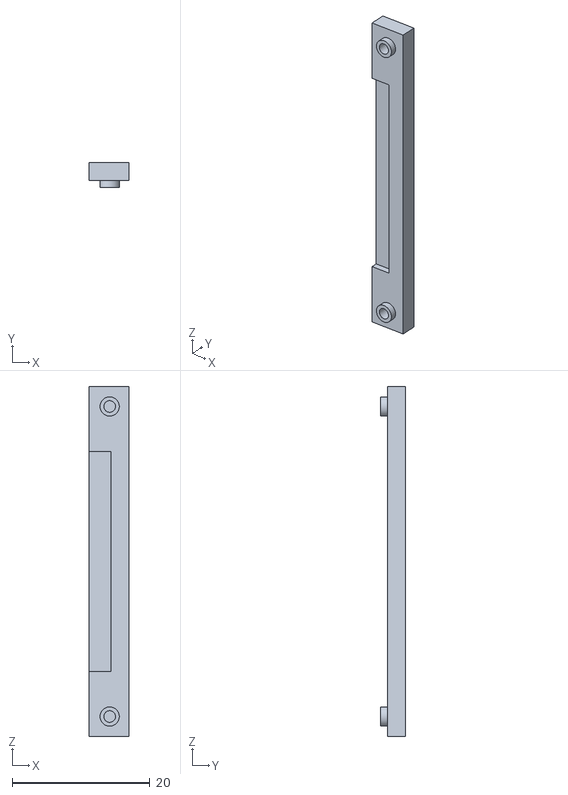
[picture p63: CAD file, 2026-10-02]
Asstets/Model/STL/CaseD2.stl
5.80 x 3.60 x 50.8
