Oru-star/Doomsday-deck/Asstets/Model/STL/CaseC1.stl

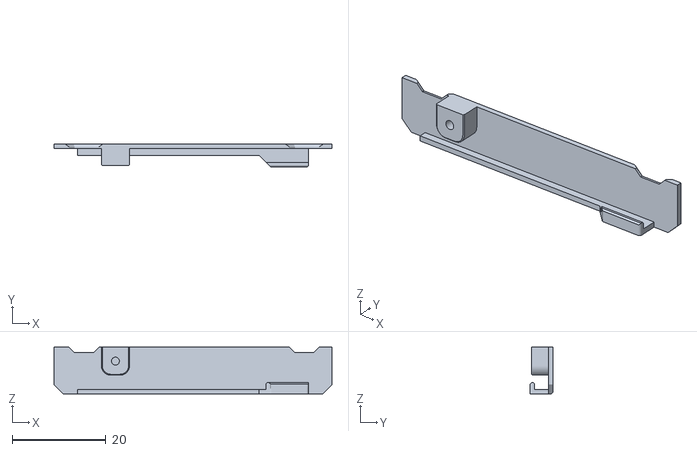
[picture p65: CAD file, 2026-10-02]
Asstets/Model/STL/CaseC1.stl
59.3 x 4.90 x 10.0
