Oru-star/Doomsday-deck/Asstets/Model/STL/CaseR1.stl

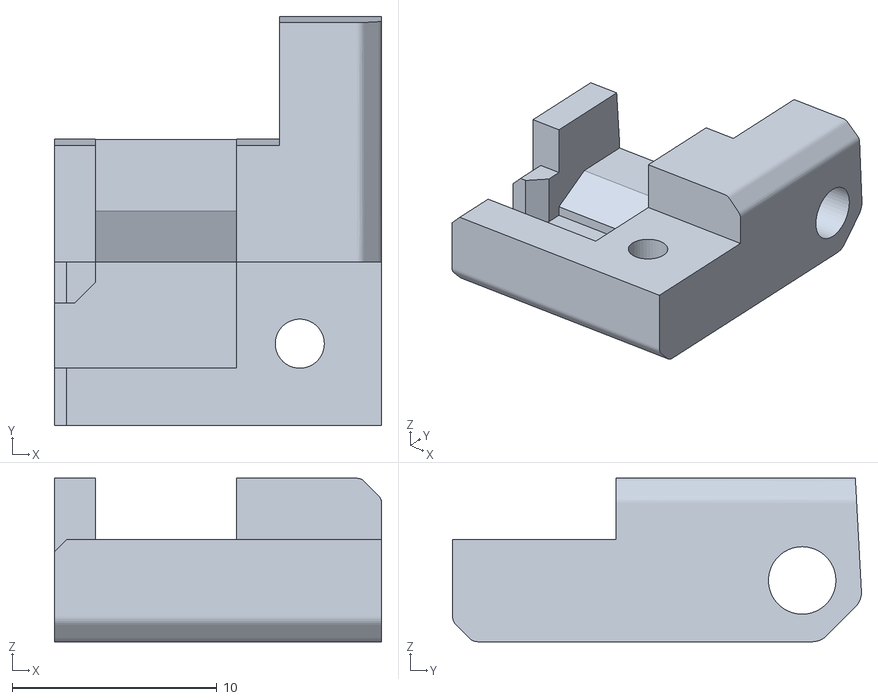
[picture p66: CAD file, 2026-10-02]
Asstets/Model/STL/CaseR1.stl
16.0 x 20.0 x 8.00
