Oru-star/Doomsday-deck/(list of files, cad)

Other CAD files:
PCB'S/KEYBOARD'S PCB/Keyboard-Doomsdaydeck.step
step's n render's/BASE/Base-Parts/LS-COVER.step
step's n render's/DISPLAY-BOTTOM/Bottom_bezzel.step
3Dprints for deck/Covers,hinge etc/Right speaker Cover.stl
Asstets/Header 2x20 2.54mm.STEP
Asstets/sma-antenna-connector-2.snapshot.3/SMA_Connector_PART.SLDPRT
3Dprints for deck/SCREEN PART/Buttons_screen.stl
Asstets/sma-antenna-connector-2.snapshot.3/Connector_Ass.IGS
PCB'S/KEYBOARD'S PCB/KEYBOARD ASSETS/kailh-low-profile-keycaps-1.snapshot.2/KailhLP Choc Keycap STEP/Default.STEP
step's n render's/BASE/Base-Parts/RS-COVER.step
3Dprints for deck/Covers,hinge etc/Cover for SDR.stl
PCB'S/KEYBOARD'S PCB/KEYBOARD ASSETS/kailh-low-profile-keycaps-1.snapshot.2/KailhLP Choc Keycap STEP/1x1.STEP
PCB'S/KEYBOARD'S PCB/KEYBOARD ASSETS/kailh-low-profile-keycaps-1.snapshot.2/KailhLP Choc Keycap STEP/Space.STEP
PCB'S/KEYBOARD'S PCB/KEYBOARD ASSETS/kailh-low-profile-keycaps-1.snapshot.2/KailhLP Choc Keycap STEP/1x1.5.STEP
PCB'S/KEYBOARD'S PCB/KEYBOARD ASSETS/kailh-low-profile-keycaps-1.snapshot.2/KailhLP Choc Keycap STEP/1.75x1.STEP
Asstets/LIB_MAX98357AETE+T/MAX98357AETE+T/3D/MAX98357AETE+T.stp
Asstets/LIB_MAX98357AETE+T/MAX98357AETE+T/Allegro/qfn50p300x300x80-17n.psm
Asstets/LIB_MAX98357AETE+T/MAX98357AETE+T/DEHDL/max98357aete_t/chips/chips.prt
Asstets/LIB_USB2517I-JZX/USB2517I-JZX/Allegro/qfn50p900x900x100-65n-d.psm
Asstets/LIB_USB2517I-JZX/USB2517I-JZX/DEHDL/usb2517i_jzx/chips/chips.prt
Asstets/Model/CapTFT_V2.f3d
Asstets/cooler-40x40x10-1.snapshot.2/╨║╤â╨╗╨╡╤Ç 40╤à40╤à10.SLDASM
Asstets/orangepi-zero3w-m2-carrier-main/orangepi-zero3w-m2-carrier-main/_unused_library_backup/LM2576T-3.3.step
Asstets/orangepi-zero3w-m2-carrier-main/orangepi-zero3w-m2-carrier-main/_unused_library_backup/MP2143DJ-LF-Z.step
Asstets/rtl-sdr-ver-3-1.snapshot.8/RTL_SDR-V3.f3d
Asstets/rtl-sdr-ver-3-1.snapshot.8/RTL_SDR-V3.skp
PCB'S/KEYBOARD'S PCB/KEYBOARD ASSETS/kailh-low-profile-keycaps-1.snapshot.2/KailhLP Choc Keycap IGS/1.25x1.IGS
PCB'S/KEYBOARD'S PCB/KEYBOARD ASSETS/kailh-low-profile-keycaps-1.snapshot.2/KailhLP Choc Keycap IGS/1.5x1.IGS
PCB'S/KEYBOARD'S PCB/KEYBOARD ASSETS/kailh-low-profile-keycaps-1.snapshot.2/KailhLP Choc Keycap IGS/1.75x1.IGS
PCB'S/KEYBOARD'S PCB/KEYBOARD ASSETS/kailh-low-profile-keycaps-1.snapshot.2/KailhLP Choc Keycap IGS/1x1.25.IGS
PCB'S/KEYBOARD'S PCB/KEYBOARD ASSETS/kailh-low-profile-keycaps-1.snapshot.2/KailhLP Choc Keycap IGS/1x1.5.IGS
PCB'S/KEYBOARD'S PCB/KEYBOARD ASSETS/kailh-low-profile-keycaps-1.snapshot.2/KailhLP Choc Keycap IGS/1x1.75.IGS
PCB'S/KEYBOARD'S PCB/KEYBOARD ASSETS/kailh-low-profile-keycaps-1.snapshot.2/KailhLP Choc Keycap IGS/1x1.IGS
PCB'S/KEYBOARD'S PCB/KEYBOARD ASSETS/kailh-low-profile-keycaps-1.snapshot.2/KailhLP Choc Keycap IGS/Default.IGS
PCB'S/KEYBOARD'S PCB/KEYBOARD ASSETS/kailh-low-profile-keycaps-1.snapshot.2/KailhLP Choc Keycap IGS/Space.IGS
PCB'S/KEYBOARD'S PCB/KEYBOARD ASSETS/kailh-low-profile-keycaps-1.snapshot.2/KailhLP Choc Keycap STL/1.25x1.STL
PCB'S/KEYBOARD'S PCB/KEYBOARD ASSETS/kailh-low-profile-keycaps-1.snapshot.2/KailhLP Choc Keycap STL/1.5x1.STL
PCB'S/KEYBOARD'S PCB/KEYBOARD ASSETS/kailh-low-profile-keycaps-1.snapshot.2/KailhLP Choc Keycap STL/1.75x1.STL
PCB'S/KEYBOARD'S PCB/KEYBOARD ASSETS/kailh-low-profile-keycaps-1.snapshot.2/KailhLP Choc Keycap STL/1x1.25.STL
PCB'S/KEYBOARD'S PCB/KEYBOARD ASSETS/kailh-low-profile-keycaps-1.snapshot.2/KailhLP Choc Keycap STL/1x1.5.STL
PCB'S/KEYBOARD'S PCB/KEYBOARD ASSETS/kailh-low-profile-keycaps-1.snapshot.2/KailhLP Choc Keycap STL/1x1.75.STL
PCB'S/KEYBOARD'S PCB/KEYBOARD ASSETS/kailh-low-profile-keycaps-1.snapshot.2/KailhLP Choc Keycap STL/1x1.STL
PCB'S/KEYBOARD'S PCB/KEYBOARD ASSETS/kailh-low-profile-keycaps-1.snapshot.2/KailhLP Choc Keycap STL/Default.STL
PCB'S/KEYBOARD'S PCB/KEYBOARD ASSETS/kailh-low-profile-keycaps-1.snapshot.2/KailhLP Choc Keycap STL/Space.STL
PCB'S/KEYBOARD'S PCB/KEYBOARD ASSETS/kailh-low-profile-keycaps-1.snapshot.2/KailhLP Choc Keycap X_T/1.25x1.x_t
PCB'S/KEYBOARD'S PCB/KEYBOARD ASSETS/kailh-low-profile-keycaps-1.snapshot.2/KailhLP Choc Keycap X_T/1.5x1.x_t
PCB'S/KEYBOARD'S PCB/KEYBOARD ASSETS/kailh-low-profile-keycaps-1.snapshot.2/KailhLP Choc Keycap X_T/1.75x1.x_t
PCB'S/KEYBOARD'S PCB/KEYBOARD ASSETS/kailh-low-profile-keycaps-1.snapshot.2/KailhLP Choc Keycap X_T/1x1.25.x_t
PCB'S/KEYBOARD'S PCB/KEYBOARD ASSETS/kailh-low-profile-keycaps-1.snapshot.2/KailhLP Choc Keycap X_T/1x1.5.x_t
PCB'S/KEYBOARD'S PCB/KEYBOARD ASSETS/kailh-low-profile-keycaps-1.snapshot.2/KailhLP Choc Keycap X_T/1x1.75.x_t
PCB'S/KEYBOARD'S PCB/KEYBOARD ASSETS/kailh-low-profile-keycaps-1.snapshot.2/KailhLP Choc Keycap X_T/1x1.x_t
PCB'S/KEYBOARD'S PCB/KEYBOARD ASSETS/kailh-low-profile-keycaps-1.snapshot.2/KailhLP Choc Keycap X_T/Default.x_t
PCB'S/KEYBOARD'S PCB/KEYBOARD ASSETS/kailh-low-profile-keycaps-1.snapshot.2/KailhLP Choc Keycap X_T/Space.x_t
PCB'S/KEYBOARD'S PCB/KEYBOARD ASSETS/kailh-low-profile-mechanical-keyboard-switch-1.snapshot.1/Kailh LP Choc Burnt Orange.IGS
PCB'S/KEYBOARD'S PCB/KEYBOARD ASSETS/kailh-low-profile-mechanical-keyboard-switch-1.snapshot.1/Kailh LP Choc Burnt Orange.SLDPRT
PCB'S/KEYBOARD'S PCB/KEYBOARD ASSETS/kailh-low-profile-mechanical-keyboard-switch-1.snapshot.1/Kailh LP Choc Burnt Orange.x_b
PCB'S/KEYBOARD'S PCB/KEYBOARD ASSETS/kailh-low-profile-mechanical-keyboard-switch-1.snapshot.1/Kailh LP Choc Burnt Orange.x_t
PCB'S/KEYBOARD'S PCB/KEYBOARD ASSETS/seeed-studio-xiao-rp2040-3d-model/Seeed Studio XIAO RP2040 v26.f3d
step's n render's/DECK-TOP/TOP_PANNEL.f3d
step's n render's/DISPLAY-BOTTOM/Bottom_bezzel.f3d
step's n render's/DISPLAY-TOP/BUTTON'S.f3d
step's n render's/DISPLAY-TOP/TOP_BEZZEL.f3d
