Oru-star/Doomsday-deck/(list of files, drawings)

Other design files:
Asstets/LIB_MAX98357AETE+T/MAX98357AETE+T/Altium/MAX98357AETE+T.SchLib
Asstets/LIB_MAX98357AETE+T/MAX98357AETE+T/Altium/QFN50P300X300X80-17N.PcbLib
Asstets/LIB_USB2517I-JZX/USB2517I-JZX/Altium/QFN50P900X900X100-65N-D.PcbLib
Asstets/LIB_USB2517I-JZX/USB2517I-JZX/Altium/USB2517I-JZX.SchLib
