Oru-star/Doomsday-deck/PCB'S/CARRIER BOARD PCB/carrier-orange pi zero 3w.kicad_pcb

## KiCad design PCB'S/CARRIER BOARD PCB/carrier-orange pi zero 3w.kicad_pcb (2026-11-02)

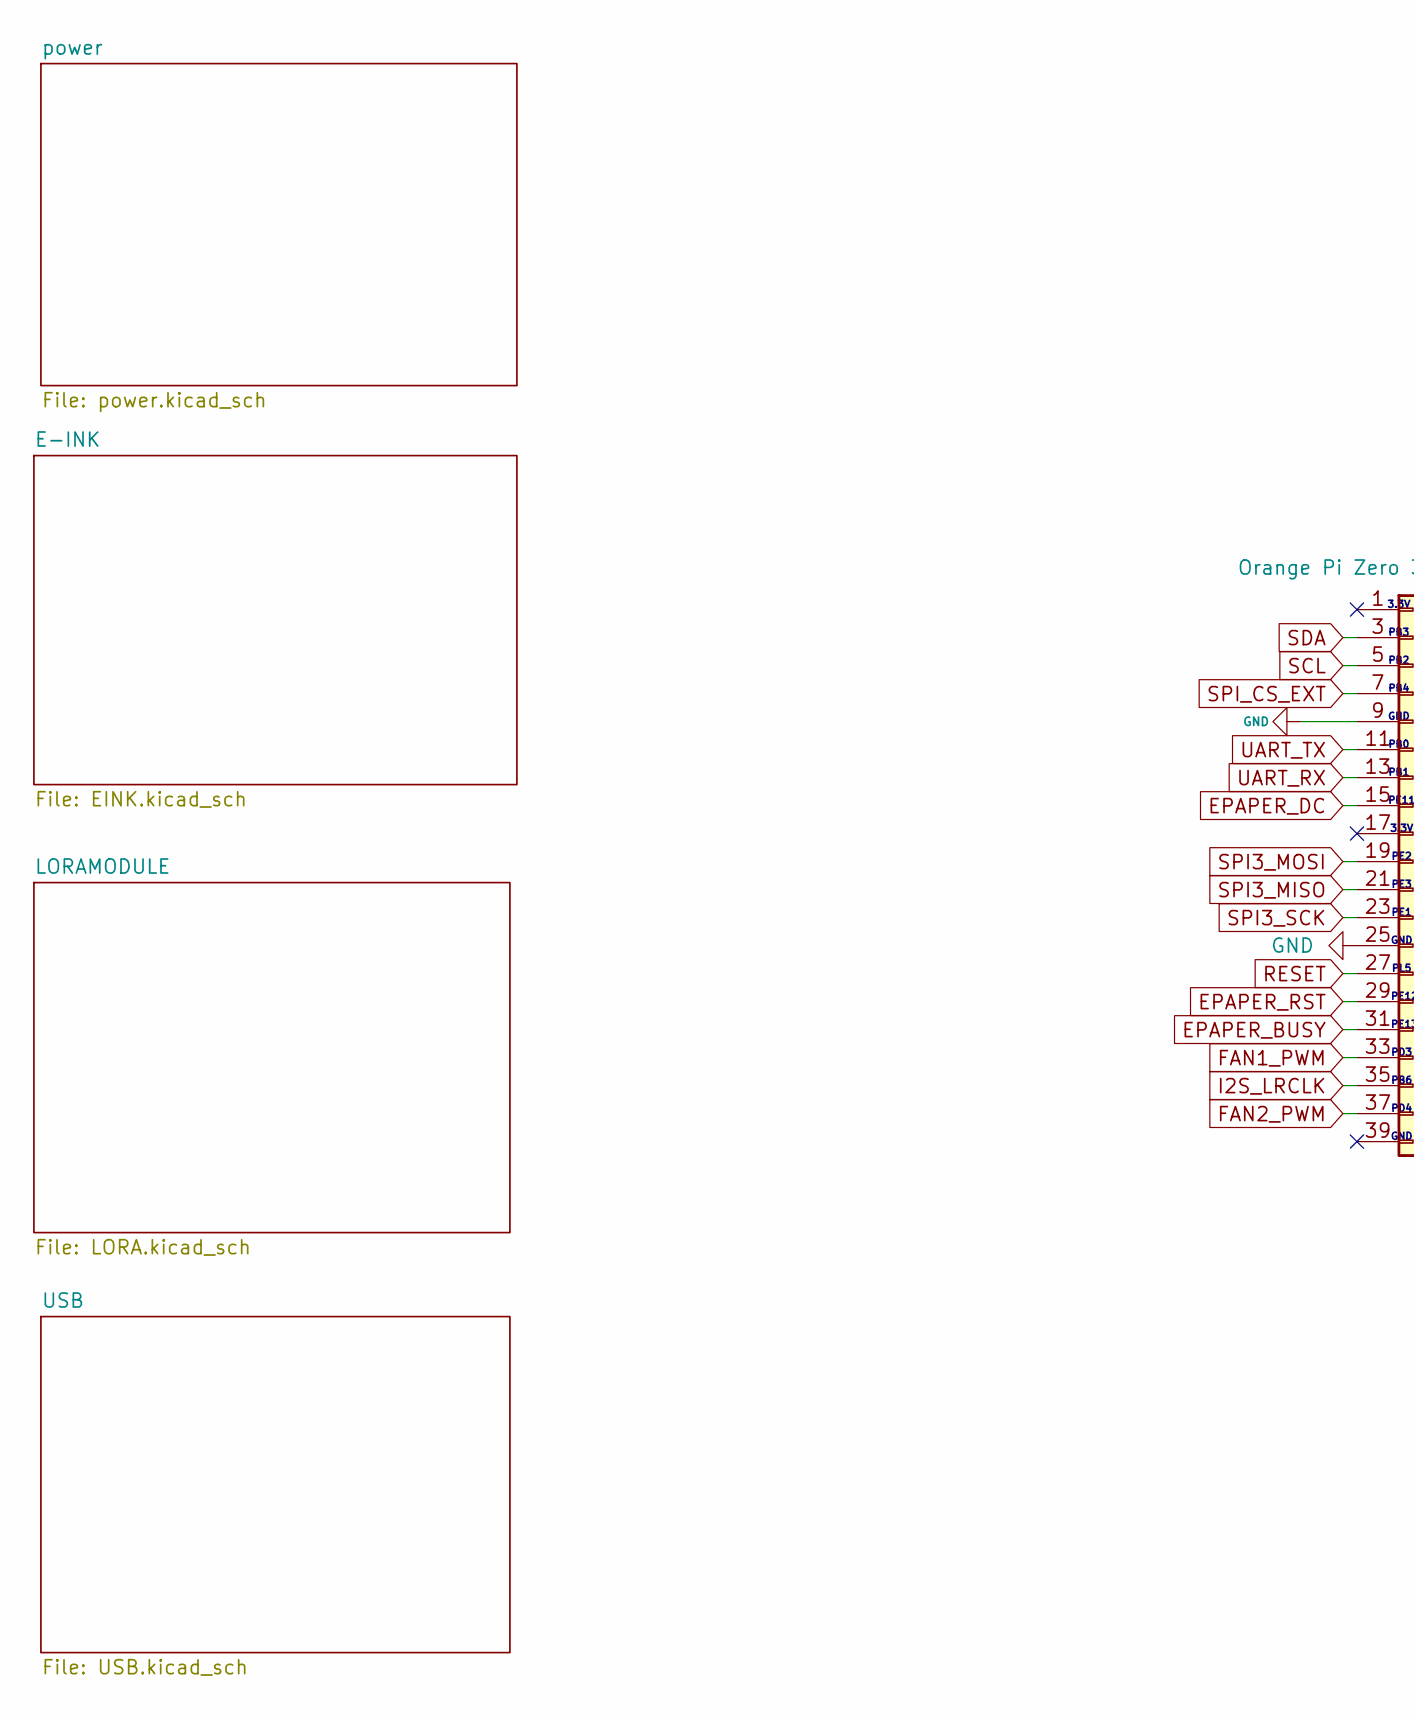
[picture p67: schematic carrier-orange pi zero 3w.kicad_sch, part in row 1, column 1]

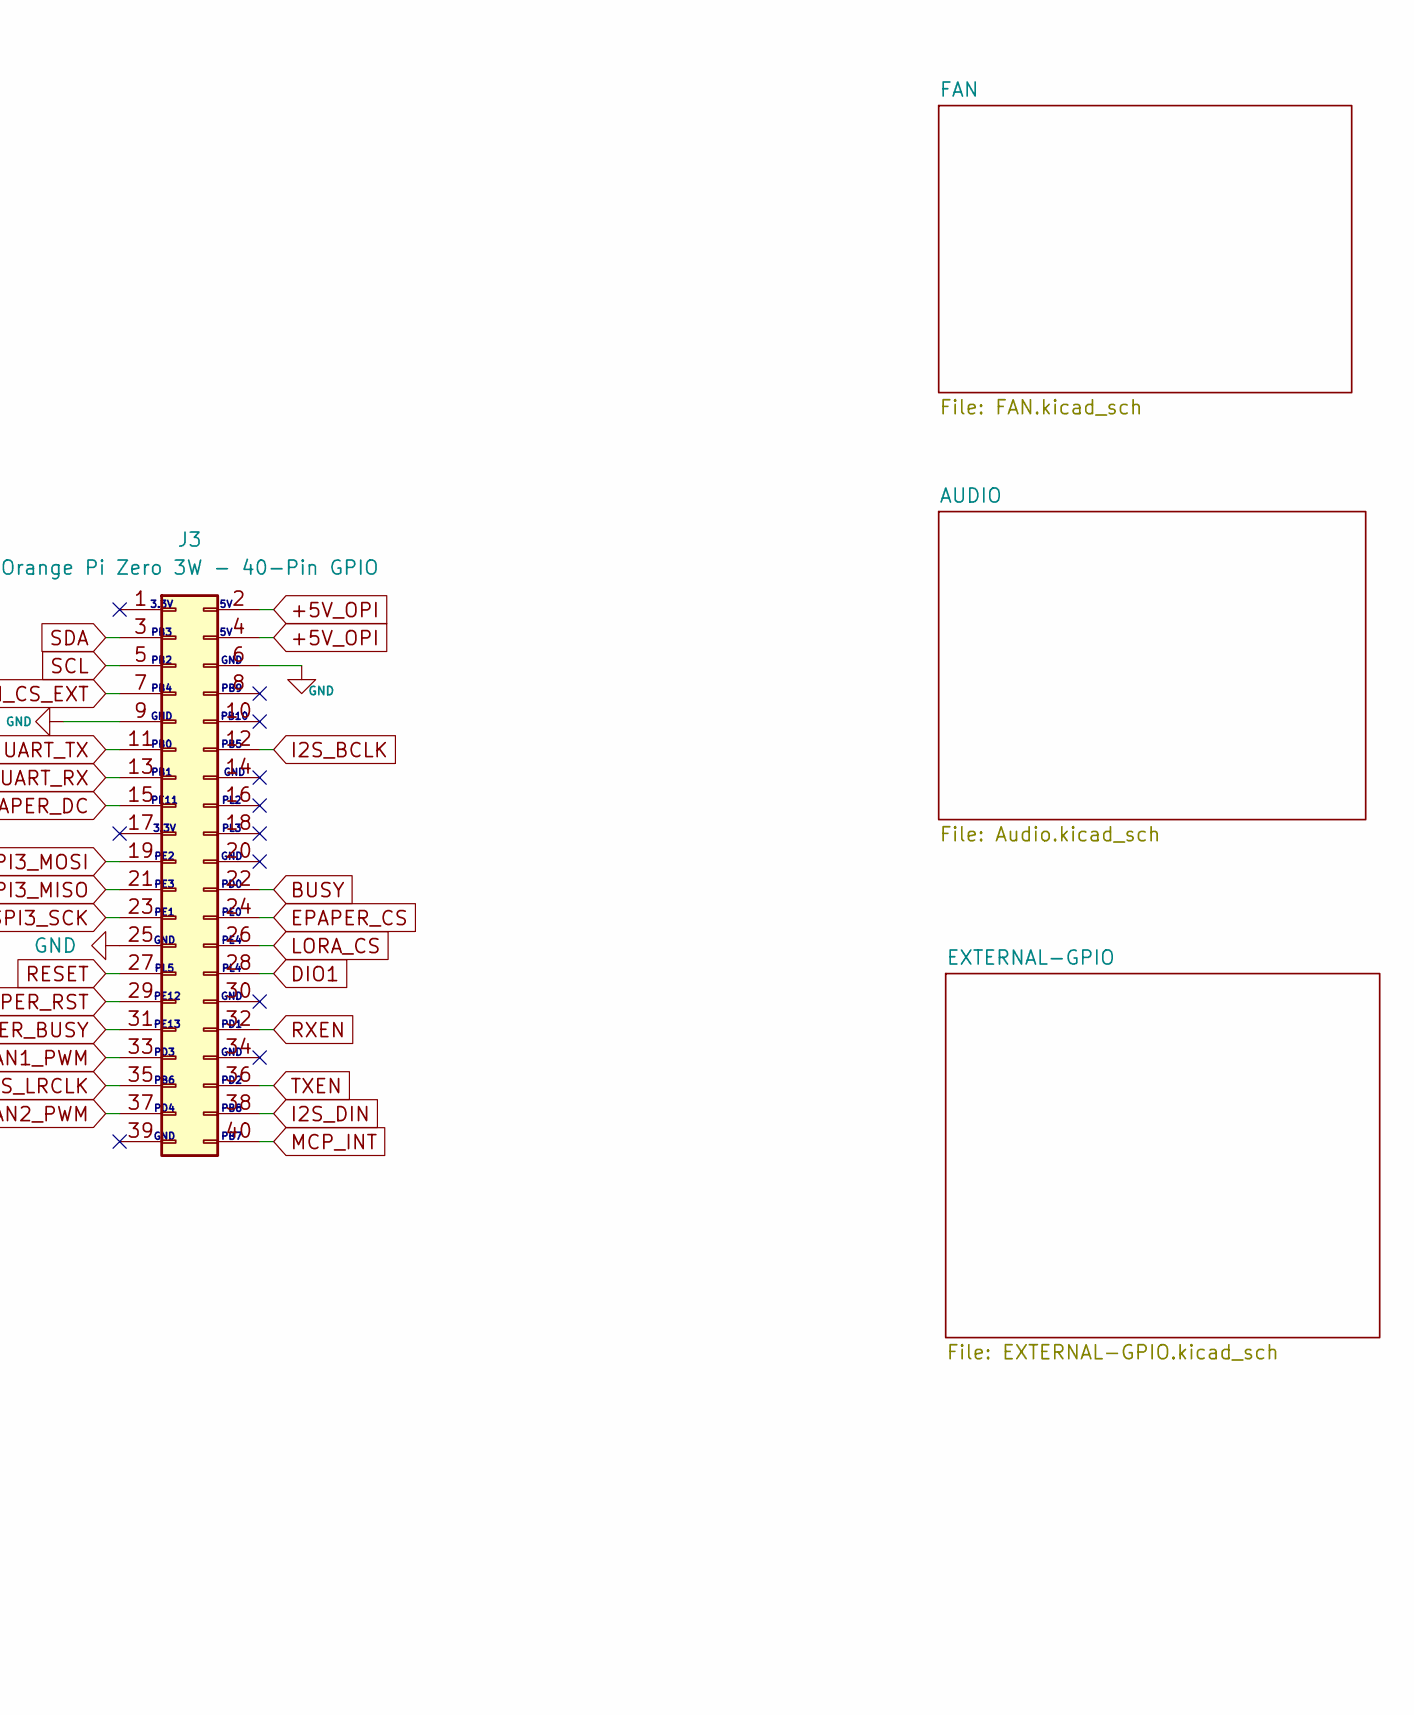
[picture p68: schematic carrier-orange pi zero 3w.kicad_sch, part in row 1, column 2]

Parts:
J3: Orange Pi Zero 3W - 40-Pin GPIO; PinHeader_2x20_P2.54mm_Vertical

Connections:
+5V_OPI: J3.2, J3.4; also elsewhere on the board
BUSY: J3.22; also elsewhere on the board
DIO1: J3.28; also elsewhere on the board
EPAPER_BUSY: J3.31; also elsewhere on the board
EPAPER_CS: J3.24; also elsewhere on the board
EPAPER_DC: J3.15; also elsewhere on the board
EPAPER_RST: J3.29; also elsewhere on the board
FAN1_PWM: J3.33; also elsewhere on the board
FAN2_PWM: J3.37; also elsewhere on the board
GND: J3.6, J3.9, J3.25; also elsewhere on the board
I2S_BCLK: J3.12; also elsewhere on the board
I2S_DIN: J3.38; also elsewhere on the board
I2S_LRCLK: J3.35; also elsewhere on the board
LORA_CS: J3.26; also elsewhere on the board
MCP_INT: J3.40; also elsewhere on the board
RESET: J3.27; also elsewhere on the board
RXEN: J3.32; also elsewhere on the board
SCL: J3.5; also elsewhere on the board
SDA: J3.3; also elsewhere on the board
SPI3_MISO: J3.21; also elsewhere on the board
SPI3_MOSI: J3.19; also elsewhere on the board
SPI3_SCK: J3.23; also elsewhere on the board
SPI_CS_EXT: J3.7; also elsewhere on the board
TXEN: J3.36; also elsewhere on the board
UART_RX: J3.13; also elsewhere on the board
UART_TX: J3.11; also elsewhere on the board

Notes on the sheet:
PD3
PE1
PB4
PL3
PL4
PE2
PB2
GND
PB0
PB10
GND
PE13
PE11
PE3
PL5
PD4
PD2
3.3V
PB8
PL2
PB7
PB9
PB5
PE4
PD1
PE0
PB6
PB1
PD0
PE12
PB3

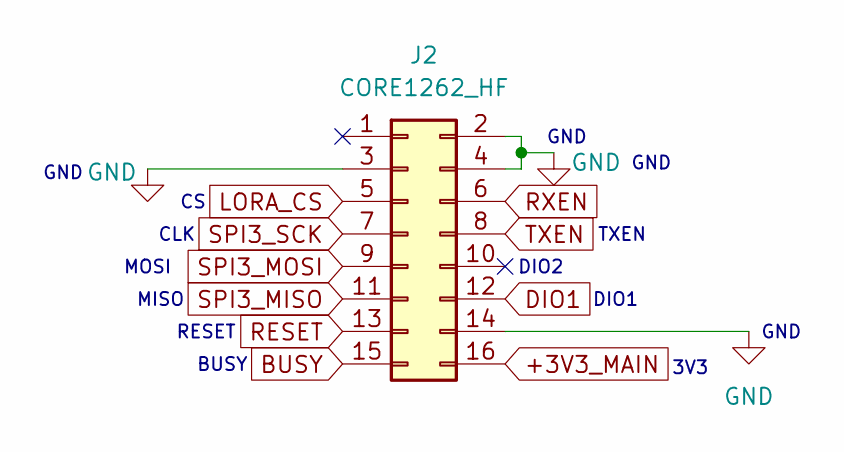
[picture p69: schematic LORA.kicad_sch]

Parts:
J2: CORE1262_HF; Core1262_HF

Connections:
+3V3_MAIN: J2.16; also elsewhere on the board
BUSY: J2.15; also elsewhere on the board
DIO1: J2.12; also elsewhere on the board
GND: J2.2, J2.3, J2.4, J2.14; also elsewhere on the board
LORA_CS: J2.5; also elsewhere on the board
RESET: J2.13; also elsewhere on the board
RXEN: J2.6; also elsewhere on the board
SPI3_MISO: J2.11; also elsewhere on the board
SPI3_MOSI: J2.9; also elsewhere on the board
SPI3_SCK: J2.7; also elsewhere on the board
TXEN: J2.8; also elsewhere on the board

Notes on the sheet:
GND
DIO2
BUSY
3V3
DIO1
TXEN
CLK
MOSI
MISO
RESET

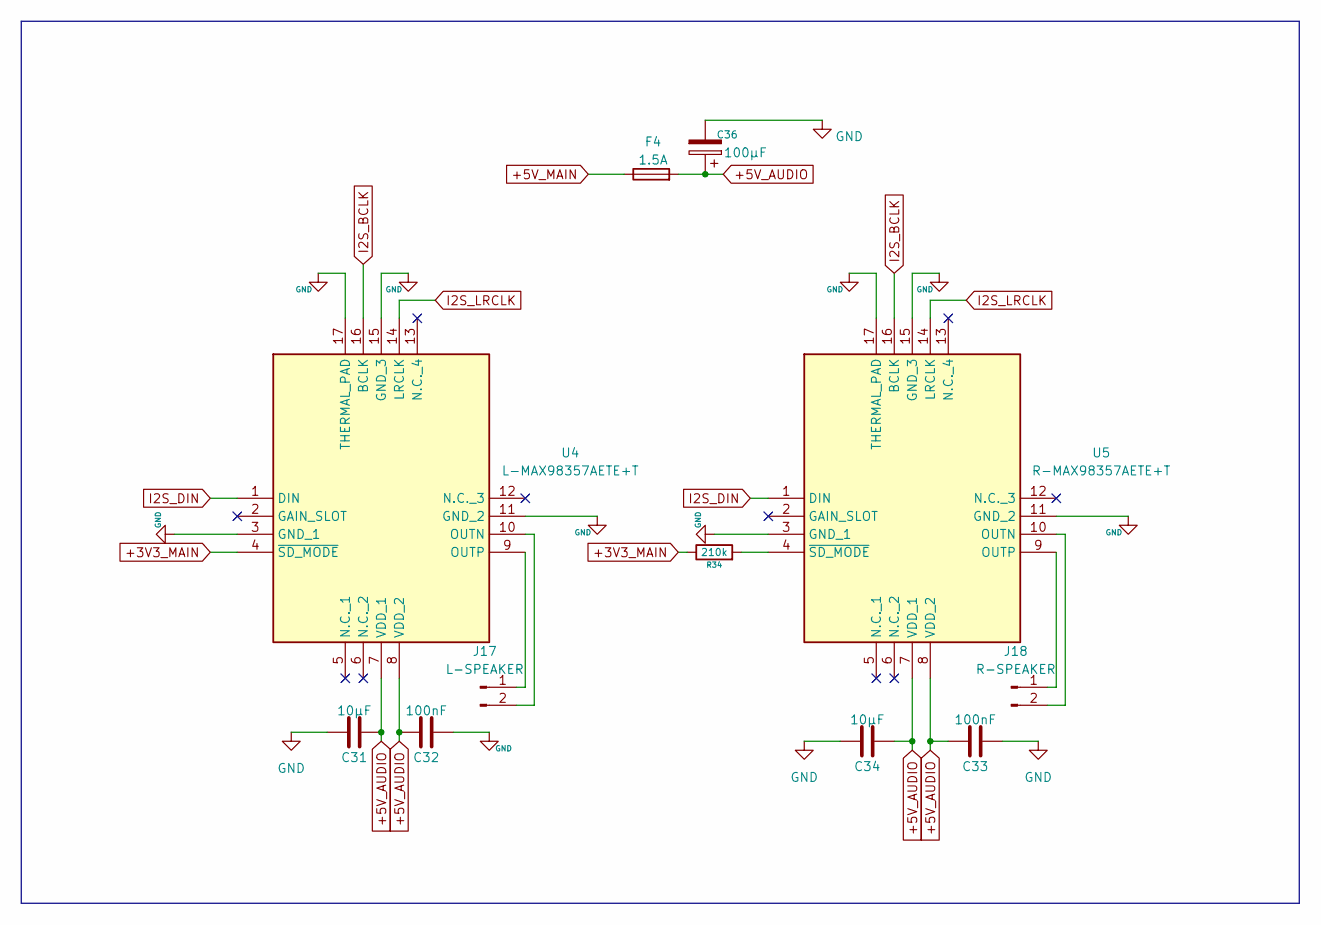
[picture p70: schematic Audio.kicad_sch]

Parts:
C31, C34: 10µF; C_0805_2012Metric
C32, C33: 100nF; C_0805_2012Metric
C36: 100µF; CP_Elec_6.3x7.7
F4: 1.5A; Fuse_1812_4532Metric
J17: L-SPEAKER; JST_VH_B2P-VH_1x02_P3.96mm_Vertical
J18: R-SPEAKER; JST_VH_B2P-VH_1x02_P3.96mm_Vertical
R34: 210k; R_0805_2012Metric
U4: L-MAX98357AETE+T; QFN50P300X300X80-17N; Manufacturer_Part_Number MAX98357AETE+T; Mouser Part Number 700-MAX98357AETE+T
U5: R-MAX98357AETE+T; QFN50P300X300X80-17N; Manufacturer_Part_Number MAX98357AETE+T; Mouser Part Number 700-MAX98357AETE+T

Connections:
+3V3_MAIN: R34.1, U4.4 (~SD_MODE); also elsewhere on the board
+5V_AUDIO: C31.2, C32.1, C33.1, C34.2, C36.1, F4.2, U4.7 (VDD_1), U4.8 (VDD_2), U5.7 (VDD_1), U5.8 (VDD_2)
+5V_MAIN: F4.1; also elsewhere on the board
GND: C31.1, C32.2, C33.2, C34.1, C36.2, U4.3 (GND_1), U4.11 (GND_2), U4.15 (GND_3), U4.17 (THERMAL_PAD), U5.3 (GND_1), U5.11 (GND_2), U5.15 (GND_3), U5.17 (THERMAL_PAD); also elsewhere on the board
I2S_BCLK: U4.16 (BCLK), U5.16 (BCLK); also elsewhere on the board
I2S_DIN: U4.1 (DIN), U5.1 (DIN); also elsewhere on the board
I2S_LRCLK: U4.14 (LRCLK), U5.14 (LRCLK); also elsewhere on the board
unnamed: J17.1, U4.9 (OUTP)
unnamed: J17.2, U4.10 (OUTN)
unnamed: J18.1, U5.9 (OUTP)
unnamed: J18.2, U5.10 (OUTN)
unnamed: R34.2, U5.4 (~SD_MODE)

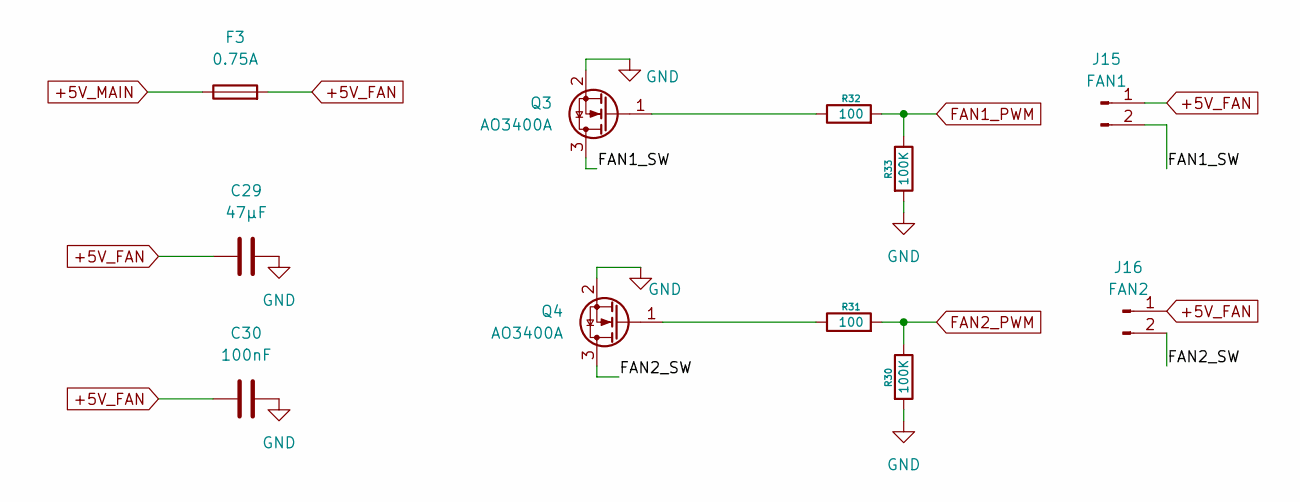
[picture p71: schematic FAN.kicad_sch]

Parts:
C29: 47µF; C_0805_2012Metric
C30: 100nF; C_0805_2012Metric
F3: 0.75A; Fuse_1206_3216Metric
J15: FAN1; JST_VH_B2P-VH_1x02_P3.96mm_Vertical
J16: FAN2; JST_VH_B2P-VH_1x02_P3.96mm_Vertical
Q3, Q4: AO3400A; SOT-23
R30, R33: 100K; R_0805_2012Metric
R31, R32: 100; R_0805_2012Metric

Connections:
+5V_FAN: C29.1, C30.1, F3.2, J15.1, J16.1
+5V_MAIN: F3.1; also elsewhere on the board
/FAN/FAN1_SW: J15.2, Q3.3 (D)
/FAN/FAN2_SW: J16.2, Q4.3 (D)
FAN1_PWM: R32.2, R33.1; also elsewhere on the board
FAN2_PWM: R30.1, R31.2; also elsewhere on the board
GND: C29.2, C30.2, Q3.2 (S), Q4.2 (S), R30.2, R33.2; also elsewhere on the board
unnamed: Q3.1 (G), R32.1
unnamed: Q4.1 (G), R31.1

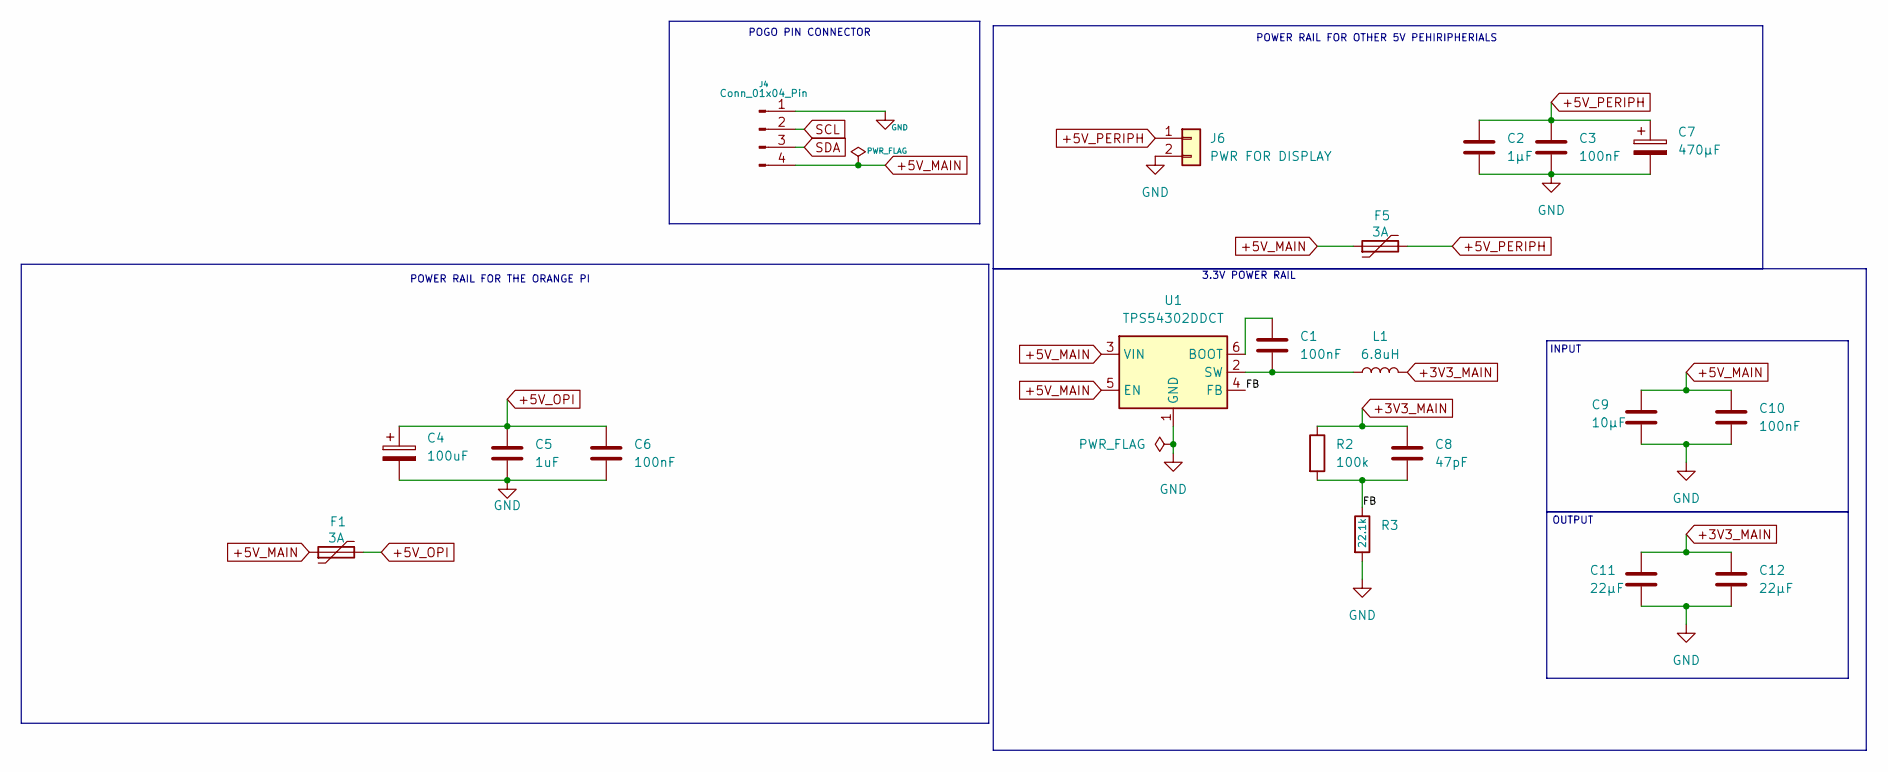
[picture p72: schematic power.kicad_sch]

Parts:
C1, C3, C6, C10: 100nF; C_0805_2012Metric
C2: 1µF; C_0805_2012Metric
C4: 100uF; CP_Radial_D6.3mm_P2.50mm
C5: 1uF; C_0805_2012Metric
C7: 470µF; C_Elec_8x10.2
C8: 47pF; C_0805_2012Metric
C9: 10µF; C_1206_3216Metric
C11, C12: 22µF; C_1206_3216Metric
F1, F5: 3A; Fuse_1812_4532Metric
J4: Conn_01x04_Pin; UPS_HAT_E_Mating
J6: PWR FOR DISPLAY; PinHeader_1x02_P2.54mm_Vertical
L1: 6.8uH; L_Sunlord_SWPA8040S
R2: 100k; R_0805_2012Metric
R3: 22.1k; R_0805_2012Metric
U1: TPS54302DDCT; SOT-23-6

Connections:
+3V3_MAIN: C8.1, C11.1, C12.1, L1.2, R2.1; also elsewhere on the board
+5V_MAIN: C9.1, C10.1, F1.1, F5.1, J4.4, U1.3 (VIN), U1.5 (EN); also elsewhere on the board
+5V_OPI: C4.1, C5.1, C6.1, F1.2; also elsewhere on the board
+5V_PERIPH: C2.1, C3.1, C7.1, F5.2, J6.1; also elsewhere on the board
/power/FB: C8.2, R2.2, R3.1, U1.4 (FB)
GND: C2.2, C3.2, C4.2, C5.2, C6.2, C7.2, C9.2, C10.2, C11.2, C12.2, J4.1, J6.2, R3.2, U1.1 (GND); also elsewhere on the board
unnamed: C1.1, U1.6 (BOOT)
unnamed: C1.2, L1.1, U1.2 (SW)
SCL: J4.2; also elsewhere on the board
SDA: J4.3; also elsewhere on the board

Notes on the sheet:
OUTPUT
INPUT
POWER RAIL FOR THE ORANGE PI
3.3V POWER RAIL
POGO PIN CONNECTOR
POWER RAIL FOR OTHER 5V PEHIRIPHERIALS

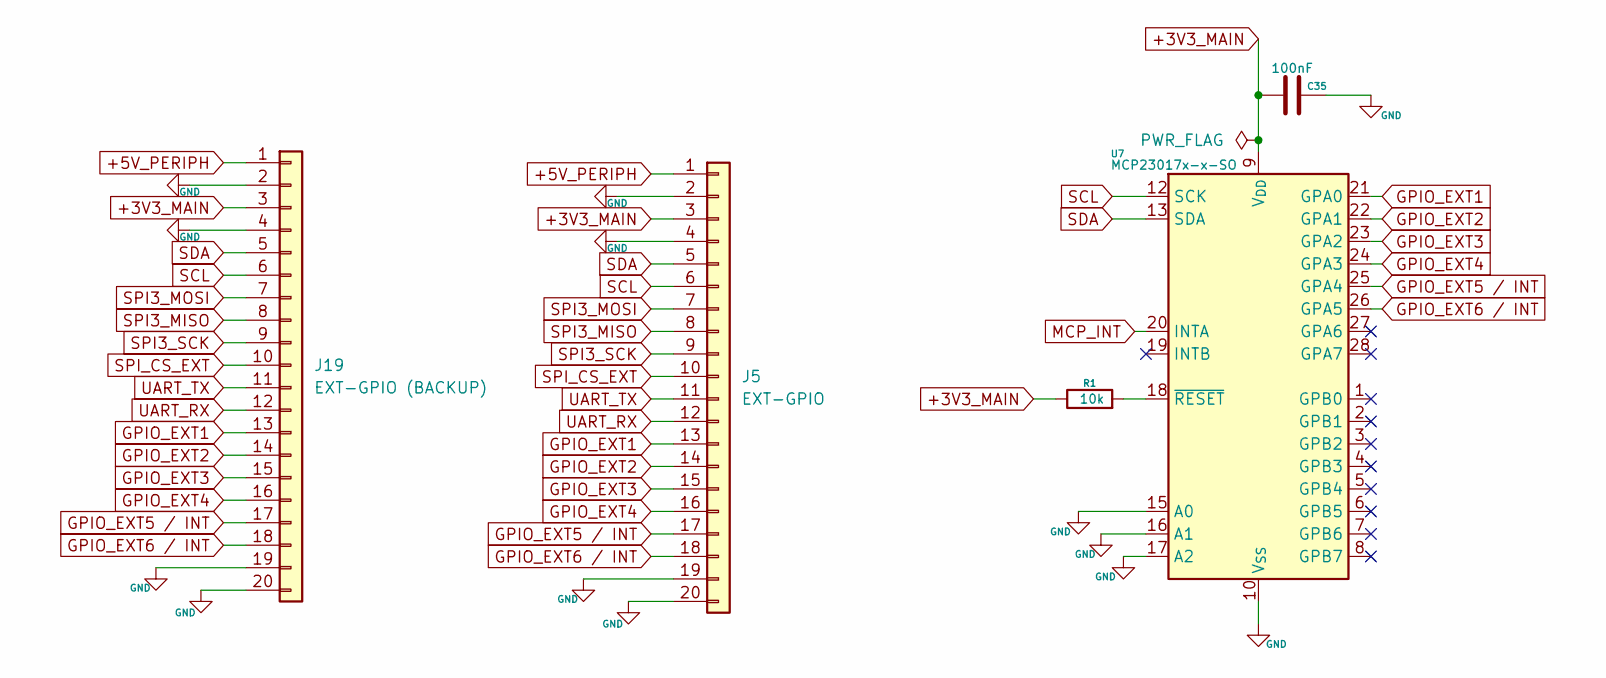
[picture p73: schematic EXTERNAL-GPIO.kicad_sch]

Parts:
C35: 100nF; C_0805_2012Metric
J5: EXT-GPIO; TE_2-84952-0_1x20-1MP_P1.0mm_Horizontal
J19: EXT-GPIO (BACKUP); PinHeader_2x10_P2.54mm_Vertical
R1: 10k; R_0805_2012Metric
U7: MCP23017x-x-SO; SOIC-28W_7.5x17.9mm_P1.27mm

Connections:
+3V3_MAIN: C35.1, J5.3, J19.3, R1.1, U7.9 (V_{DD}); also elsewhere on the board
+5V_PERIPH: J5.1, J19.1; also elsewhere on the board
GND: C35.2, J5.2, J5.4, J5.19, J5.20, J19.2, J19.4, J19.19, J19.20, U7.10 (V_{SS}), U7.15 (A0), U7.16 (A1), U7.17 (A2); also elsewhere on the board
GPIO_EXT1: J5.13, J19.13, U7.21 (GPA0)
GPIO_EXT2: J5.14, J19.14, U7.22 (GPA1)
GPIO_EXT3: J5.15, J19.15, U7.23 (GPA2)
GPIO_EXT4: J5.16, J19.16, U7.24 (GPA3)
GPIO_EXT5 / INT: J5.17, J19.17, U7.25 (GPA4)
GPIO_EXT6 / INT: J5.18, J19.18, U7.26 (GPA5)
MCP_INT: U7.20 (INTA); also elsewhere on the board
unnamed: R1.2, U7.18 (~RESET)
SCL: J5.6, J19.6, U7.12 (SCK); also elsewhere on the board
SDA: J5.5, J19.5, U7.13 (SDA); also elsewhere on the board
SPI3_MISO: J5.8, J19.8; also elsewhere on the board
SPI3_MOSI: J5.7, J19.7; also elsewhere on the board
SPI3_SCK: J5.9, J19.9; also elsewhere on the board
SPI_CS_EXT: J5.10, J19.10; also elsewhere on the board
UART_RX: J5.12, J19.12; also elsewhere on the board
UART_TX: J5.11, J19.11; also elsewhere on the board

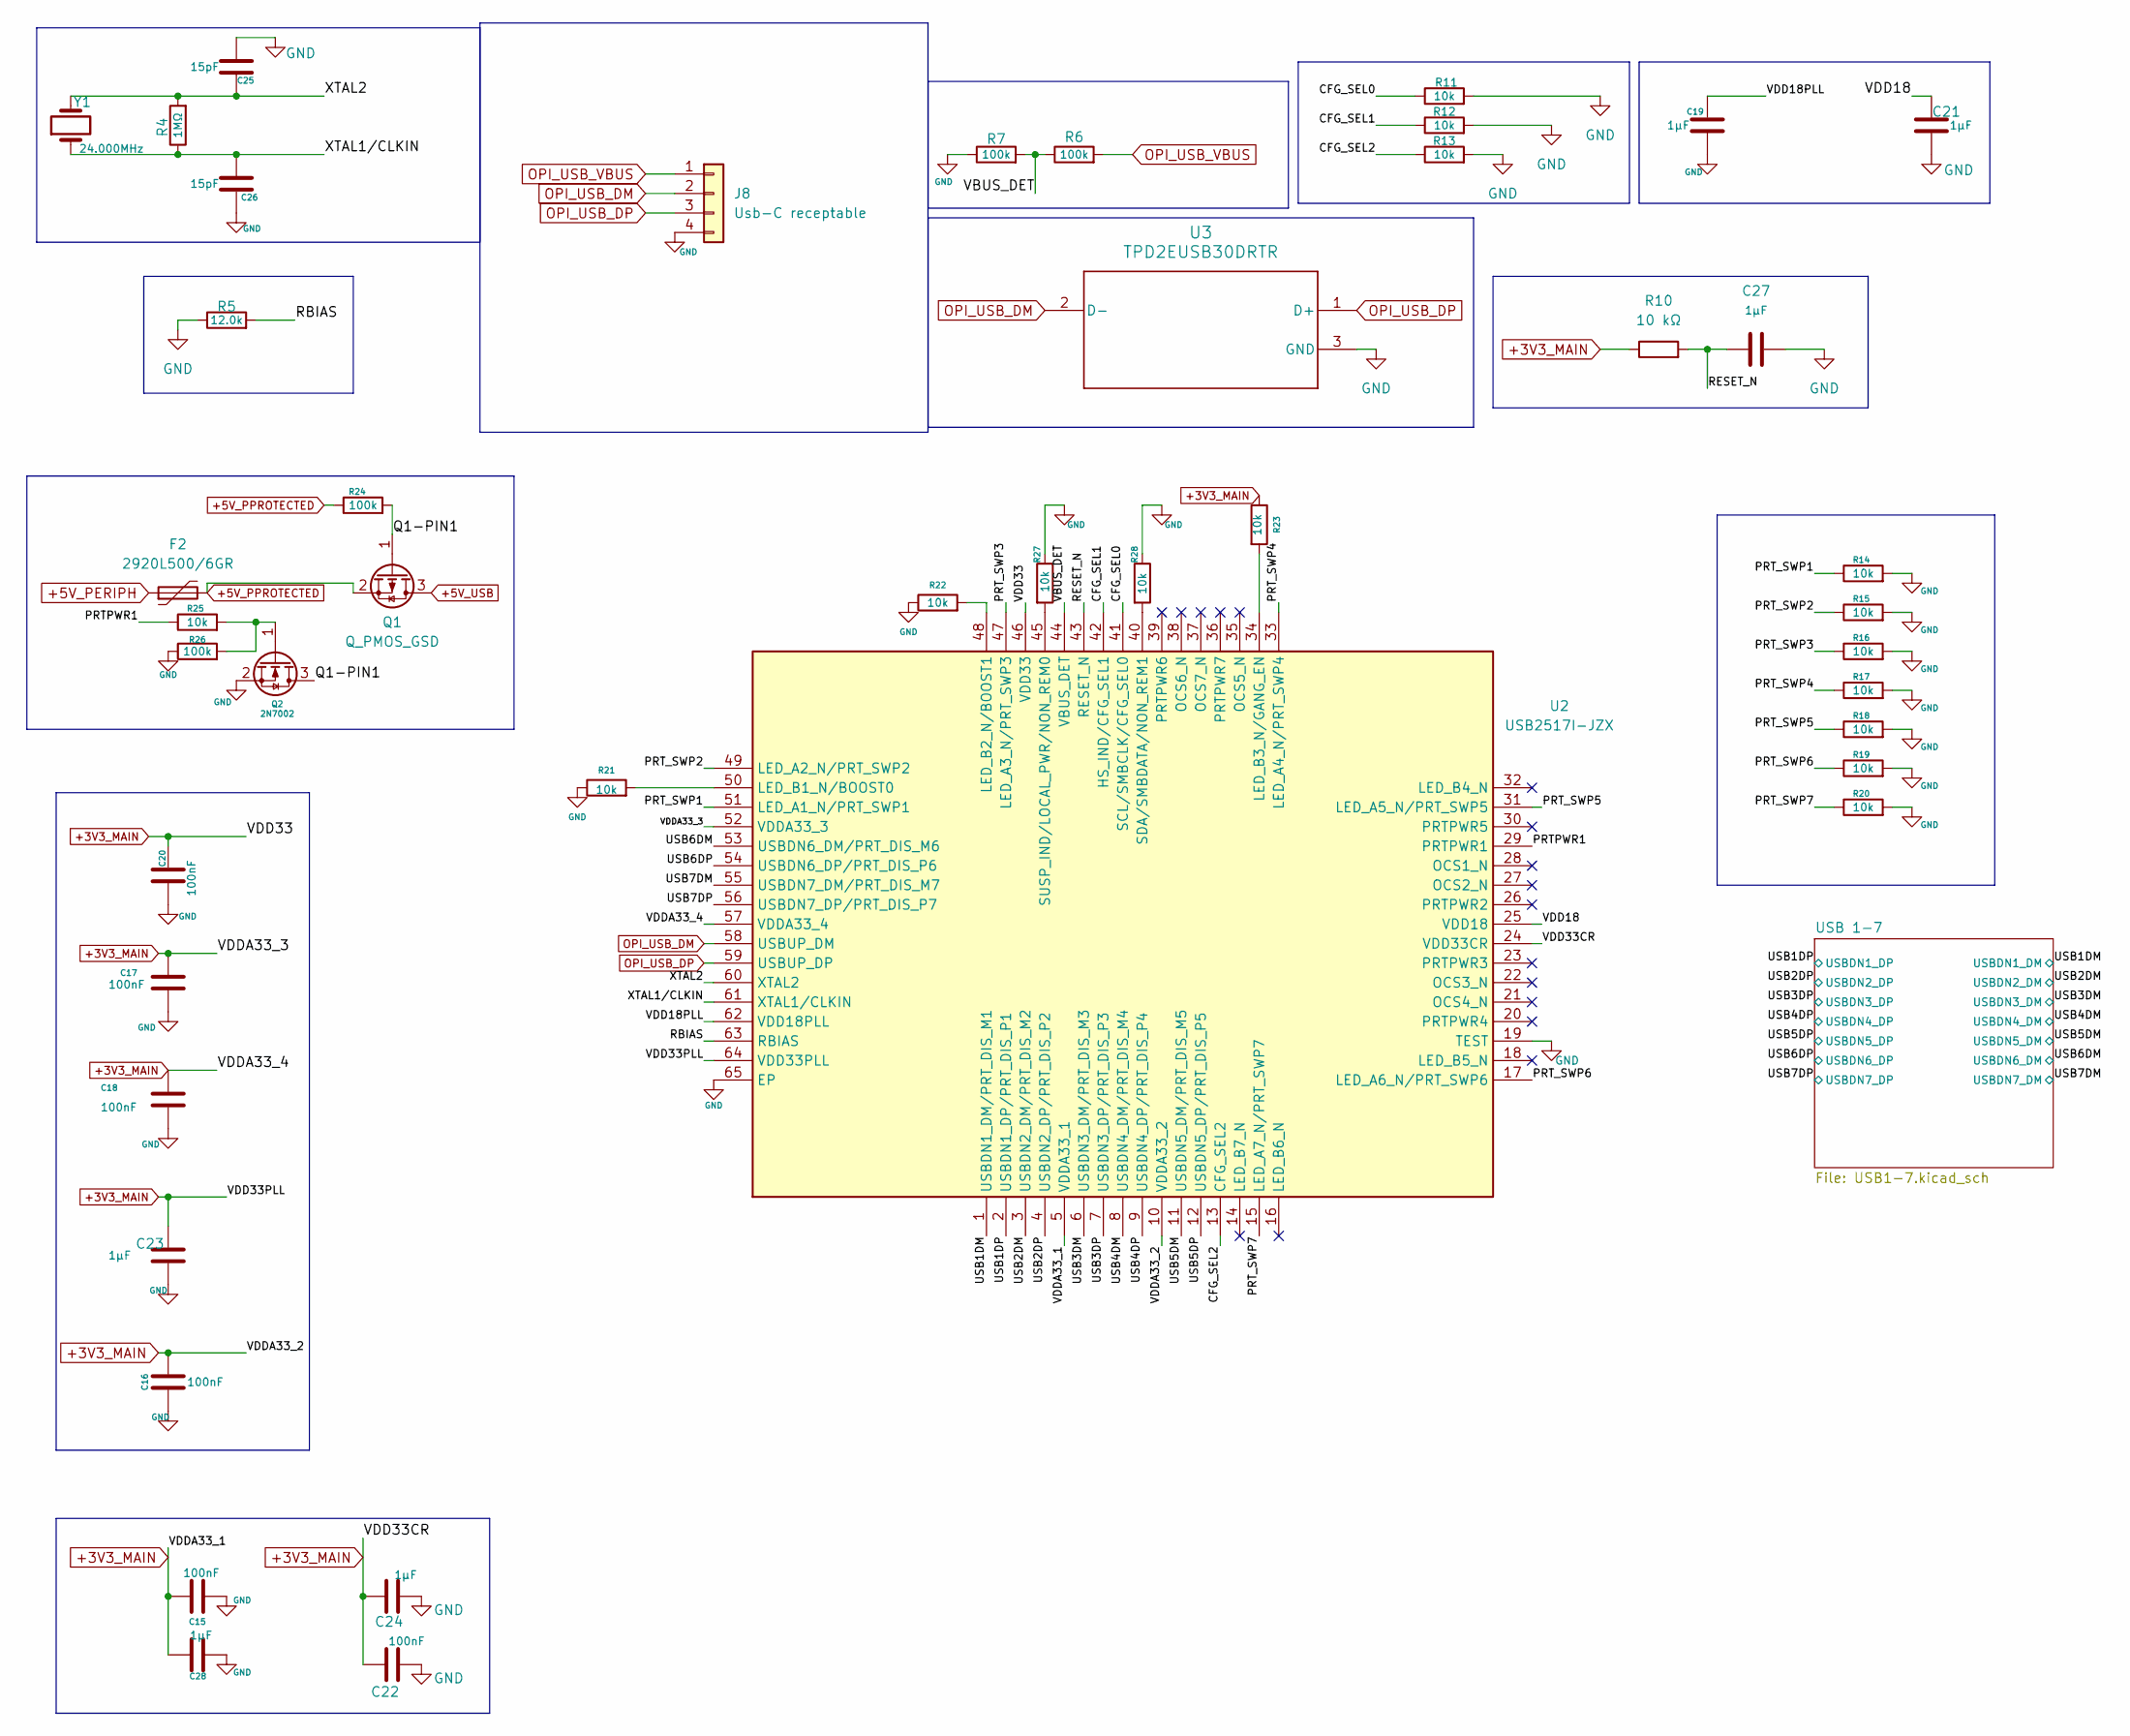
[picture p74: schematic USB.kicad_sch]

Parts:
C15, C16, C17, C18, C20, C22: 100nF; C_0805_2012Metric
C19, C21, C23, C24, C27, C28: 1µF; C_0805_2012Metric
C25, C26: 15pF; C_0805_2012Metric
F2: 2920L500/6GR; Fuse_2920_7451Metric
J8: Usb-C receptable; PinHeader_1x04_P2.54mm_Vertical
Q1: Q_PMOS_GSD; SOT-23
Q2: 2N7002; SOT-23
R4: 1MΩ; R_0805_2012Metric
R5: 12.0k; R_0805_2012Metric
R6, R7, R24, R26: 100k; R_0805_2012Metric
R10: 10 kΩ; R_0805_2012Metric
R11, R12, R13, R14, R15, R16, R17, R18, R19, R20, R21, R22, R23, R25, R27, R28: 10k; R_0805_2012Metric
U2: USB2517I-JZX; VQFN-64-1EP_9x9mm_P0.5mm_EP5.4x5.4mm_ThermalVias; Manufacturer_Part_Number USB2517I-JZX; Mouser Part Number 886-USB2517I-JZX
U3: TPD2EUSB30DRTR; SOT-723
Y1: 24.000MHz; Crystal_SMD_2016-4Pin_2.0x1.6mm

Connections:
+3V3_MAIN: C15.1, C16.1, C17.1, C18.1, C20.1, C22.1, C23.1, C24.1, C28.1, R10.1, R23.1, U2.5 (VDDA33_1), U2.10 (VDDA33_2), U2.24 (VDD33CR), U2.46 (VDD33), U2.52 (VDDA33_3), U2.57 (VDDA33_4), U2.64 (VDD33PLL); also elsewhere on the board
+5V_PERIPH: F2.1; also elsewhere on the board
+5V_PPROTECTED: F2.2, Q1.2 (S), R24.1
+5V_USB: Q1.3 (D); also elsewhere on the board
/USB/CFG_SEL0: R11.1, U2.41 (SCL/SMBCLK/CFG_SEL0)
/USB/CFG_SEL1: R12.1, U2.42 (HS_IND/CFG_SEL1)
/USB/CFG_SEL2: R13.1, U2.13 (CFG_SEL2)
/USB/PRTPWR1: R25.1, U2.29 (PRTPWR1)
/USB/PRT_SWP1: R14.1, U2.51 (LED_A1_N/PRT_SWP1)
/USB/PRT_SWP2: R15.1, U2.49 (LED_A2_N/PRT_SWP2)
/USB/PRT_SWP3: R16.1, U2.47 (LED_A3_N/PRT_SWP3)
/USB/PRT_SWP4: R17.1, U2.33 (LED_A4_N/PRT_SWP4)
/USB/PRT_SWP5: R18.1, U2.31 (LED_A5_N/PRT_SWP5)
/USB/PRT_SWP6: R19.1, U2.17 (LED_A6_N/PRT_SWP6)
/USB/PRT_SWP7: R20.1, U2.15 (LED_A7_N/PRT_SWP7)
/USB/Q1-PIN1: Q1.1 (G), Q2.3 (D), R24.2
/USB/RBIAS: R5.2, U2.63 (RBIAS)
/USB/RESET_N: C27.1, R10.2, U2.43 (RESET_N)
/USB/USB1DM: U2.1 (USBDN1_DM/PRT_DIS_M1); also elsewhere on the board
/USB/USB1DP: U2.2 (USBDN1_DP/PRT_DIS_P1); also elsewhere on the board
/USB/USB2DM: U2.3 (USBDN2_DM/PRT_DIS_M2); also elsewhere on the board
/USB/USB2DP: U2.4 (USBDN2_DP/PRT_DIS_P2); also elsewhere on the board
/USB/USB3DM: U2.6 (USBDN3_DM/PRT_DIS_M3); also elsewhere on the board
/USB/USB3DP: U2.7 (USBDN3_DP/PRT_DIS_P3); also elsewhere on the board
/USB/USB4DM: U2.8 (USBDN4_DM/PRT_DIS_M4); also elsewhere on the board
/USB/USB4DP: U2.9 (USBDN4_DP/PRT_DIS_P4); also elsewhere on the board
/USB/USB5DM: U2.11 (USBDN5_DM/PRT_DIS_M5); also elsewhere on the board
/USB/USB5DP: U2.12 (USBDN5_DP/PRT_DIS_P5); also elsewhere on the board
/USB/USB6DM: U2.53 (USBDN6_DM/PRT_DIS_M6); also elsewhere on the board
/USB/USB6DP: U2.54 (USBDN6_DP/PRT_DIS_P6); also elsewhere on the board
/USB/USB7DM: U2.55 (USBDN7_DM/PRT_DIS_M7); also elsewhere on the board
/USB/USB7DP: U2.56 (USBDN7_DP/PRT_DIS_P7); also elsewhere on the board
/USB/VBUS_DET: R6.1, R7.2, U2.44 (VBUS_DET)
/USB/VDD18: C21.1, U2.25 (VDD18)
/USB/VDD18PLL: C19.1, U2.62 (VDD18PLL)
/USB/XTAL1/CLKIN: C26.1, R4.1, U2.61 (XTAL1/CLKIN), Y1.1
/USB/XTAL2: C25.2, R4.2, U2.60 (XTAL2), Y1.2
GND: C15.2, C16.2, C17.2, C18.2, C19.2, C20.2, C21.2, C22.2, C23.2, C24.2, C25.1, C26.2, C27.2, C28.2, J8.4, Q2.2 (S), R5.1, R7.1, R11.2, R12.2, R13.2, R14.2, R15.2, R16.2, R17.2, R18.2, R19.2, R20.2, R21.1, R22.1, R26.1, R27.1, R28.1, U2.19 (TEST), U2.65 (EP), U3.3 (GND); also elsewhere on the board
unnamed: Q2.1 (G), R25.2, R26.2
unnamed: R21.2, U2.50 (LED_B1_N/BOOST0)
unnamed: R22.2, U2.48 (LED_B2_N/BOOST1)
unnamed: R23.2, U2.34 (LED_B3_N/GANG_EN)
unnamed: R28.2, U2.40 (SDA/SMBDATA/NON_REM1)
unnamed: R27.2, U2.45 (SUSP_IND/LOCAL_PWR/NON_REM0)
OPI_USB_DM: J8.2, U2.58 (USBUP_DM), U3.2 (D-)
OPI_USB_DP: J8.3, U2.59 (USBUP_DP), U3.1 (D+)
OPI_USB_VBUS: J8.1, R6.2

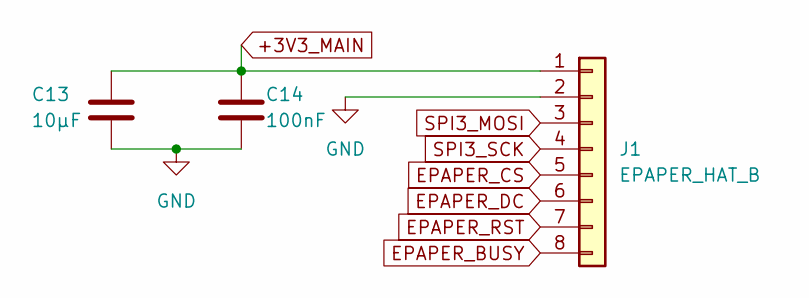
[picture p75: schematic EINK.kicad_sch]

Parts:
C13: 10µF; C_0805_2012Metric
C14: 100nF; C_0805_2012Metric
J1: EPAPER_HAT_B; PinHeader_1x08_P2.54mm_Vertical

Connections:
+3V3_MAIN: C13.1, C14.1, J1.1; also elsewhere on the board
EPAPER_BUSY: J1.8; also elsewhere on the board
EPAPER_CS: J1.5; also elsewhere on the board
EPAPER_DC: J1.6; also elsewhere on the board
EPAPER_RST: J1.7; also elsewhere on the board
GND: C13.2, C14.2, J1.2; also elsewhere on the board
SPI3_MOSI: J1.3; also elsewhere on the board
SPI3_SCK: J1.4; also elsewhere on the board
