Oru-star/Doomsday-deck/PCB'S/CARRIER BOARD PCB/carrier-orange pi zero 3w.kicad_pcb

## KiCad design PCB'S/CARRIER BOARD PCB/carrier-orange pi zero 3w.kicad_pcb (continued)

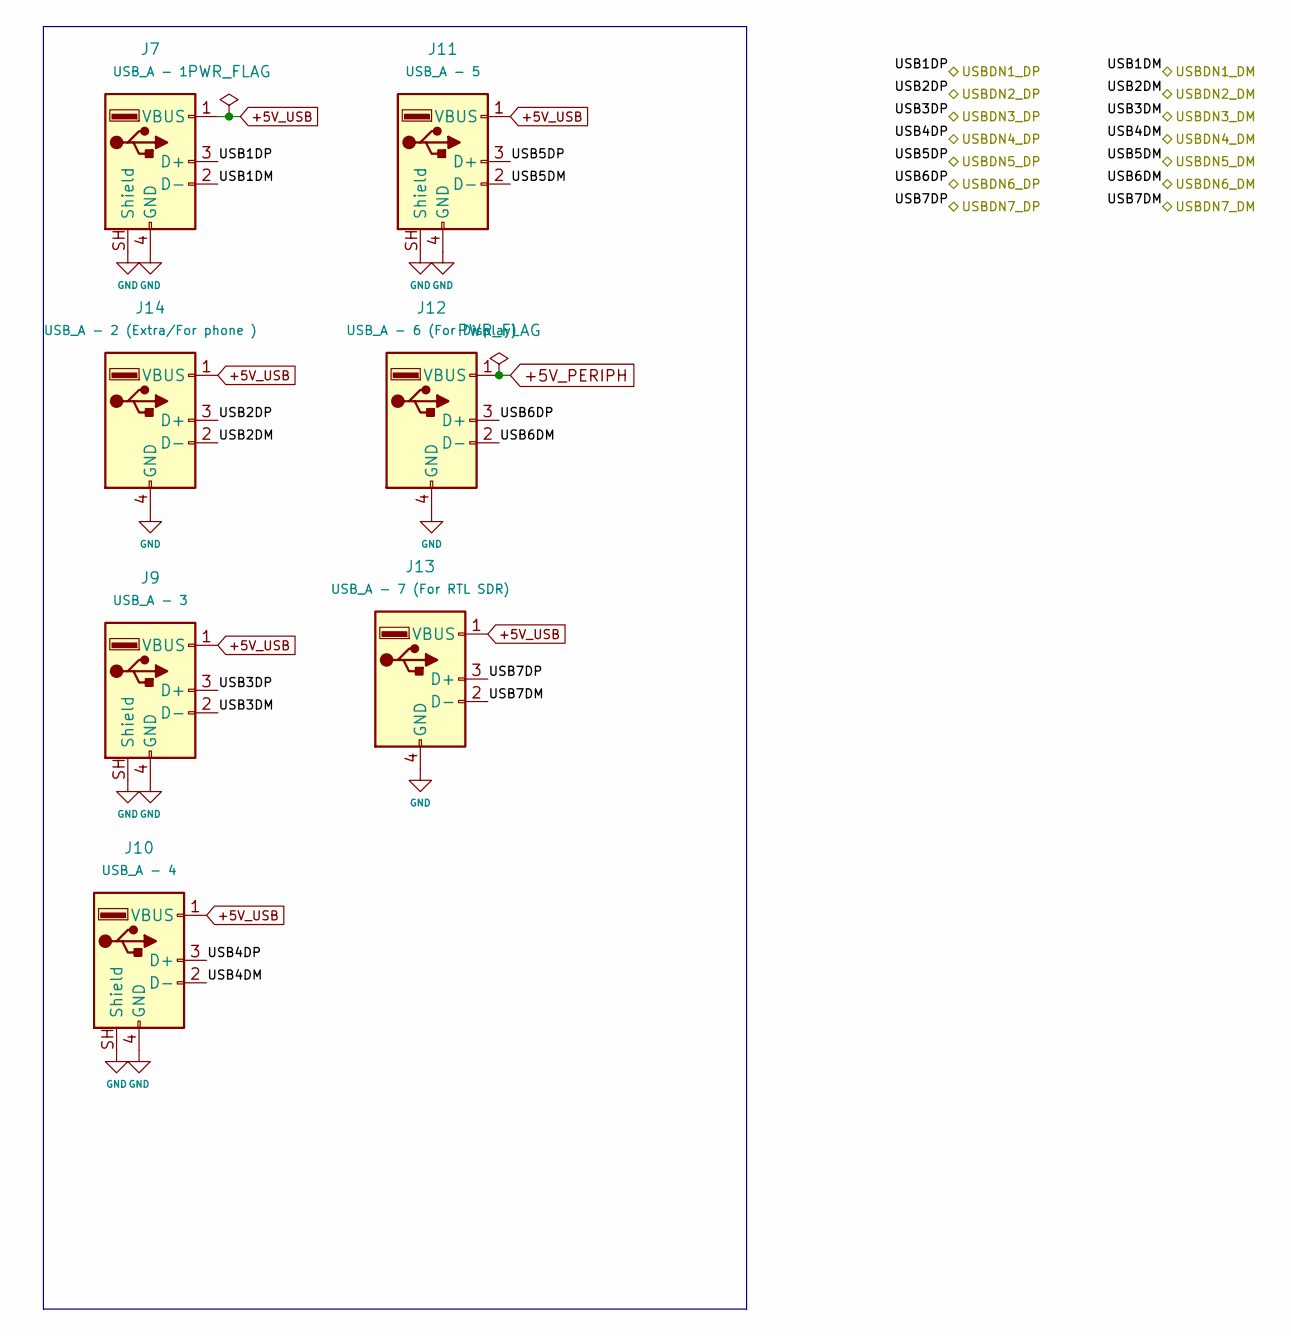
[picture p76: schematic USB1-7.kicad_sch]

Parts:
J7: USB_A - 1; USB_A_Molex_48037-2200_Horizontal
J9: USB_A - 3; USB_A_Molex_48037-2200_Horizontal
J10: USB_A - 4; USB_A_Molex_48037-2200_Horizontal
J11: USB_A - 5; USB_A_Molex_48037-2200_Horizontal
J12: USB_A - 6 (For Display); PinHeader_1x04_P2.54mm_Vertical
J13: USB_A - 7 (For RTL SDR); PinHeader_1x04_P2.54mm_Vertical
J14: USB_A - 2 (Extra/For phone ); PinHeader_1x04_P2.54mm_Vertical

Connections:
+5V_PERIPH: J12.1 (VBUS); also elsewhere on the board
+5V_USB: J7.1 (VBUS), J9.1 (VBUS), J10.1 (VBUS), J11.1 (VBUS), J13.1 (VBUS), J14.1 (VBUS); also elsewhere on the board
/USB/USB1DM: J7.2 (D-); also elsewhere on the board
/USB/USB1DP: J7.3 (D+); also elsewhere on the board
/USB/USB2DM: J14.2 (D-); also elsewhere on the board
/USB/USB2DP: J14.3 (D+); also elsewhere on the board
/USB/USB3DM: J9.2 (D-); also elsewhere on the board
/USB/USB3DP: J9.3 (D+); also elsewhere on the board
/USB/USB4DM: J10.2 (D-); also elsewhere on the board
/USB/USB4DP: J10.3 (D+); also elsewhere on the board
/USB/USB5DM: J11.2 (D-); also elsewhere on the board
/USB/USB5DP: J11.3 (D+); also elsewhere on the board
/USB/USB6DM: J12.2 (D-); also elsewhere on the board
/USB/USB6DP: J12.3 (D+); also elsewhere on the board
/USB/USB7DM: J13.2 (D-); also elsewhere on the board
/USB/USB7DP: J13.3 (D+); also elsewhere on the board
GND: J7.4 (GND), J7.SH (Shield), J9.4 (GND), J9.SH (Shield), J10.4 (GND), J10.SH (Shield), J11.4 (GND), J11.SH (Shield), J12.4 (GND), J13.4 (GND), J14.4 (GND); also elsewhere on the board

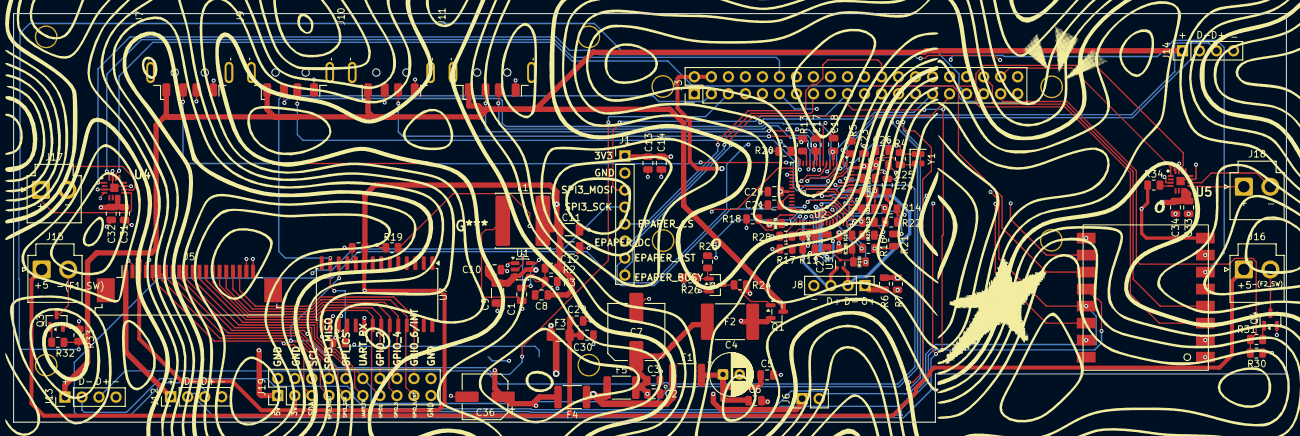
[picture p77: board PCB'S/CARRIER BOARD PCB/carrier-orange pi zero 3w.kicad_pcb from above]

Board: 4 copper layers, 190.0 x 61.0 mm, 103 parts (1 on the bottom side), 94 nets.
