Oru-star/Doomsday-deck/PCB'S/KEYBOARD'S PCB/Keyboard-Doomsdaydeck.kicad_pcb

## KiCad design PCB'S/KEYBOARD'S PCB/Keyboard-Doomsdaydeck.kicad_pcb (2026-11-02)

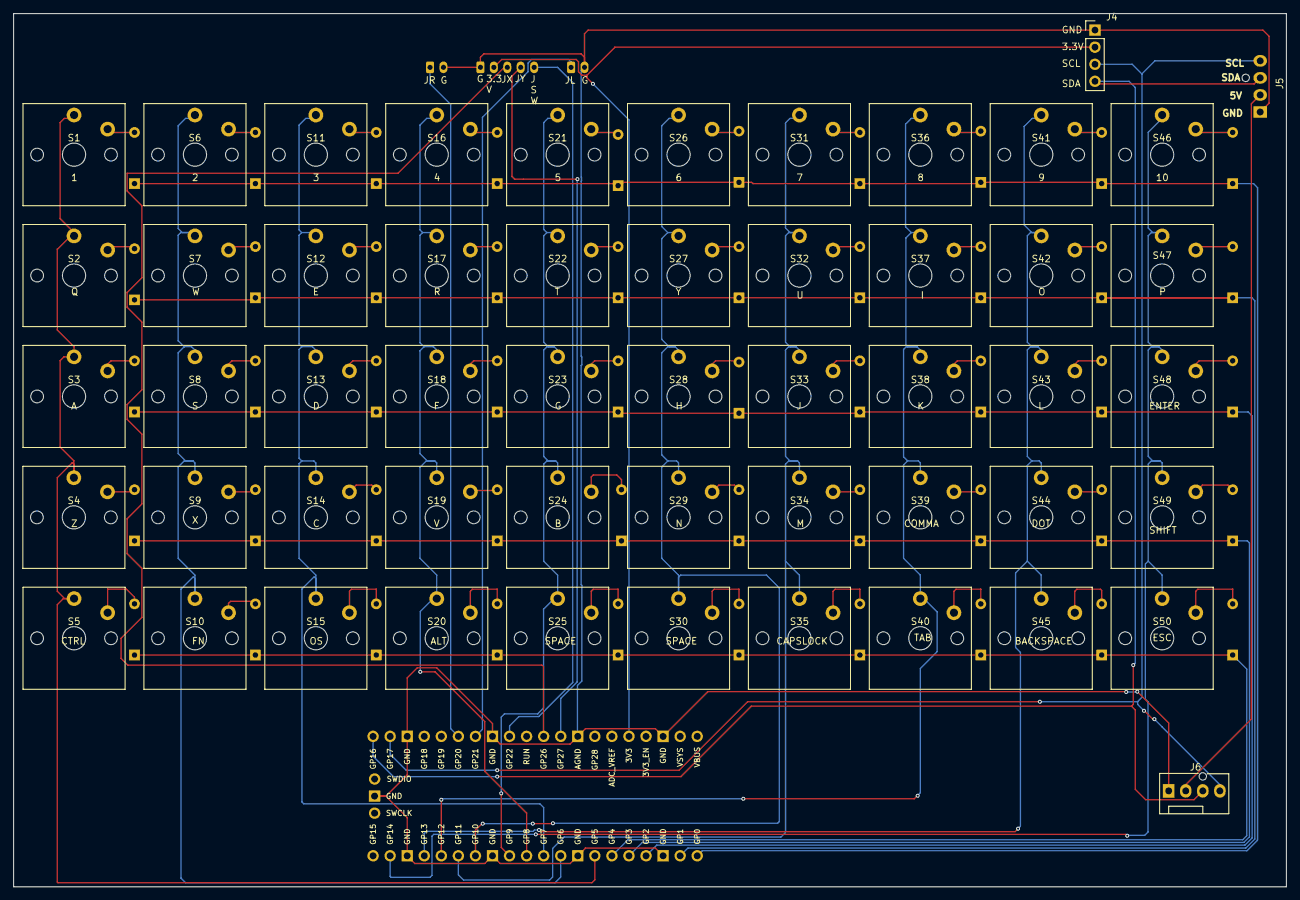
[picture p78: board Keyboard-Doomsdaydeck.kicad_pcb from above]

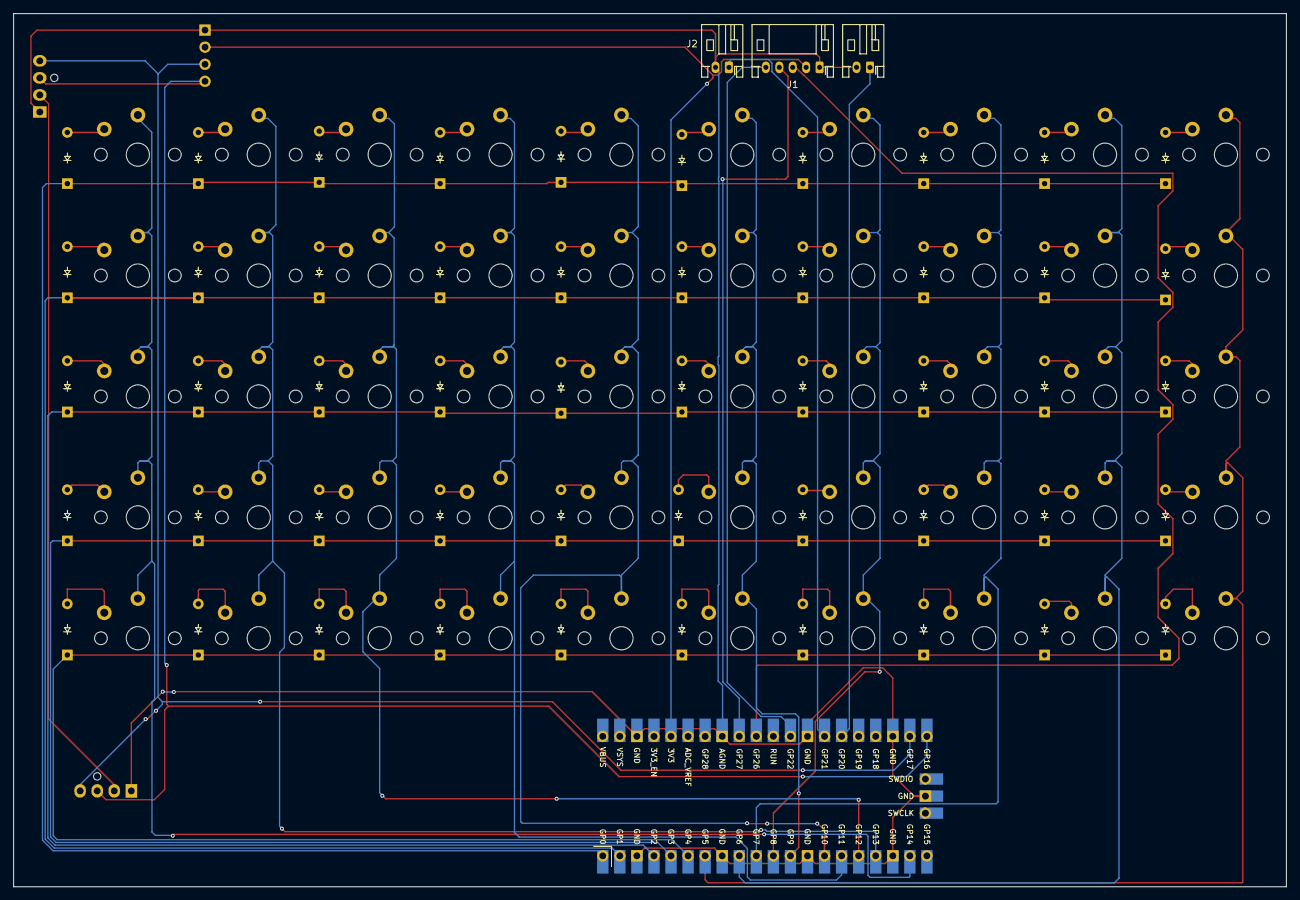
[picture p79: board Keyboard-Doomsdaydeck.kicad_pcb from below]

Board: 2 copper layers, 189.5 x 130.0 mm, 107 parts (54 on the bottom side), 75 nets.

Parts:
D1, D2, D3, D4, D5, D6, D7, D8, D9, D10, D11, D12, D13, D14, D15, D16, D17, D18, D19, D20, D21, D22, D23, D24, D25, D26, D27, D28, D29, D30, D31, D32, D33, D34, D35, D36, D37, D38, D39, D40, D41, D42, D43, D44, D45, D46, D47, D48, D49, D50: Diode_DO-35
J1: Conn_01x05; JST_PH_S5B-PH-K_1x05_P2.00mm_Horizontal
J2, J3: Conn_01x02; JST_PH_S2B-PH-K_1x02_P2.00mm_Horizontal
J4: OLED; PinHeader_1x04_P2.54mm_Vertical
J5, J6: Conn_01x04_Pin; FanPinHeader_1x04_P2.54mm_Vertical
S1, S2, S3, S4, S5, S6, S7, S8, S9, S10, S11, S12, S13, S14, S15, S16, S17, S18, S19, S20, S21, S22, S23, S24, S25, S26, S27, S28, S29, S30, S31, S32, S33, S34, S35, S36, S37, S38, S39, S40, S41, S42, S43, S44, S45, S46, S47, S48, S49, S50: SW_Kailh_Choc_V1_1.00u
U1: Raspberry_Pi_Pico2; Raspberry_Pi_Pico

Connections:
3.3V: J1.2, J4.2, U1.36 (3V3)
5V: J5.2, J6.2
COL1: S1.1, S2.1, S3.1, S4.1, S5.1, U1.7 (GPIO5)
COL2: S6.1, S7.1, S8.1, S9.1, S10.1, U1.9 (GPIO6)
COL3: S11.1, S12.1, S13.1, S14.1, S15.1, U1.10 (GPIO7)
COL4: S16.1, S17.1, S18.1, S19.1, S20.1, U1.11 (GPIO8)
COL5: S21.1, S22.1, S23.1, S24.1, S25.1, U1.12 (GPIO9)
COL6: S26.1, S27.1, S28.1, S29.1, S30.1, U1.14 (GPIO10)
COL7: S31.1, S32.1, S33.1, S34.1, S35.1, U1.15 (GPIO11)
COL8: S36.1, S37.1, S38.1, S39.1, S40.1, U1.16 (GPIO12)
COL9: S41.1, S42.1, S43.1, S44.1, S45.1, U1.17 (GPIO13)
COL10: S46.1, S47.1, S48.1, S49.1, S50.1, U1.19 (GPIO14)
GND: J1.1, J2.2, J3.2, J4.1, J5.1, J6.1, U1.3 (GND), U1.8 (GND), U1.13 (GND), U1.18 (GND), U1.23 (GND), U1.28 (GND), U1.33 (AGND), U1.38 (GND), U1.42 (GND)
JLEFT_CLICK: J2.1, U1.27 (GPIO21)
JOY_SW: J1.5, U1.29 (GPIO22)
JOY_X: J1.3, U1.31 (GPIO26_ADC0)
JOY_Y: J1.4, U1.32 (GPIO27_ADC1)
JRIGHT_CLICK: J3.1, U1.26 (GPIO20)
unnamed: D1.2 (A), S1.2
unnamed: D2.2 (A), S2.2
unnamed: D3.2 (A), S3.2
unnamed: D4.2 (A), S4.2
unnamed: D5.2 (A), S5.2
unnamed: D6.2 (A), S6.2
unnamed: D7.2 (A), S7.2
unnamed: D8.2 (A), S8.2
unnamed: D9.2 (A), S9.2
unnamed: D10.2 (A), S10.2
unnamed: D11.2 (A), S11.2
unnamed: D12.2 (A), S12.2
unnamed: D13.2 (A), S13.2
unnamed: D14.2 (A), S14.2
unnamed: D15.2 (A), S15.2
unnamed: D16.2 (A), S16.2
unnamed: D17.2 (A), S17.2
unnamed: D18.2 (A), S18.2
unnamed: D19.2 (A), S19.2
unnamed: D20.2 (A), S20.2
unnamed: D21.2 (A), S21.2
unnamed: D22.2 (A), S22.2
unnamed: D23.2 (A), S23.2
unnamed: D24.2 (A), S24.2
unnamed: D25.2 (A), S25.2
unnamed: D26.2 (A), S26.2
unnamed: D27.2 (A), S27.2
unnamed: D28.2 (A), S28.2
unnamed: D29.2 (A), S29.2
unnamed: D30.2 (A), S30.2
unnamed: D31.2 (A), S31.2
unnamed: D32.2 (A), S32.2
unnamed: D33.2 (A), S33.2
unnamed: D34.2 (A), S34.2
unnamed: D35.2 (A), S35.2
unnamed: D36.2 (A), S36.2
unnamed: D37.2 (A), S37.2
unnamed: D38.2 (A), S38.2
unnamed: D39.2 (A), S39.2
unnamed: D40.2 (A), S40.2
unnamed: D41.2 (A), S41.2
unnamed: D42.2 (A), S42.2
unnamed: D43.2 (A), S43.2
unnamed: D44.2 (A), S44.2
unnamed: D45.2 (A), S45.2
unnamed: D46.2 (A), S46.2
unnamed: D47.2 (A), S47.2
unnamed: D48.2 (A), S48.2
unnamed: D49.2 (A), S49.2
unnamed: D50.2 (A), S50.2
ROW1: D1.1 (K), D6.1 (K), D11.1 (K), D16.1 (K), D21.1 (K), D26.1 (K), D31.1 (K), D36.1 (K), D41.1 (K), D46.1 (K), U1.1 (GPIO0)
ROW2: D2.1 (K), D7.1 (K), D12.1 (K), D17.1 (K), D22.1 (K), D27.1 (K), D32.1 (K), D37.1 (K), D42.1 (K), D47.1 (K), U1.2 (GPIO1)
ROW3: D3.1 (K), D8.1 (K), D13.1 (K), D18.1 (K), D23.1 (K), D28.1 (K), D33.1 (K), D38.1 (K), D43.1 (K), D48.1 (K), U1.4 (GPIO2)
ROW4: D4.1 (K), D9.1 (K), D14.1 (K), D19.1 (K), D24.1 (K), D29.1 (K), D34.1 (K), D39.1 (K), D44.1 (K), D49.1 (K), U1.5 (GPIO3)
ROW5: D5.1 (K), D10.1 (K), D15.1 (K), D20.1 (K), D25.1 (K), D30.1 (K), D35.1 (K), D40.1 (K), D45.1 (K), D50.1 (K), U1.6 (GPIO4)
SCL: J4.3, J6.4, U1.22 (GPIO17)
SDA: J4.4, J6.3, U1.21 (GPIO16)
