Oru-star/Doomsday-deck/PCB'S/CARRIER BOARD PCB/_restore_backup_2026-09-26T11-09-31-632/carrier-orange pi zero 3w.kicad_pcb

## KiCad design PCB'S/CARRIER BOARD PCB/_restore_backup_2026-09-26T11-09-31-632/carrier-orange pi zero 3w.kicad_pcb (2026-09-26)

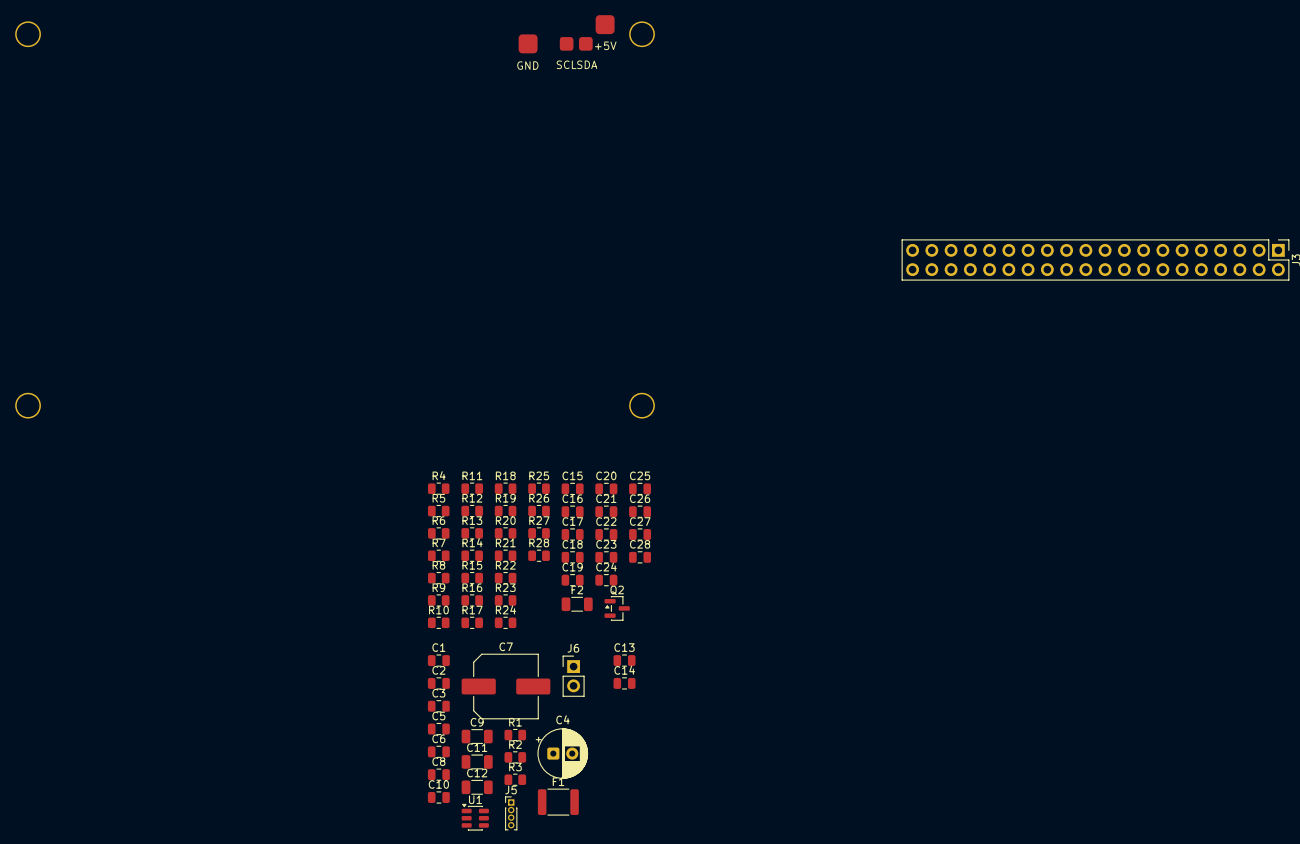
[picture p80: board PCB'S/CARRIER BOARD PCB/_restore_backup_2026-09-26T11-09-31-632/carri… from above]

Board: 2 copper layers, 64 parts (0 on the bottom side), 17 nets, no tracks yet.

Parts:
C1, C3, C6, C10, C14, C15, C16, C17, C18, C20, C22, C23: 100nF; C_0805_2012Metric
C2, C19, C21, C24, C27, C28: 1µF; C_0805_2012Metric
C4: 100uF; CP_Radial_D6.3mm_P2.50mm
C5: 1uF; C_0805_2012Metric
C7: 470µF; C_Elec_8x10.2
C8: 47pF; C_0805_2012Metric
C9: 10µF; C_1206_3216Metric
C11, C12: 22µF; C_1206_3216Metric
C13: 10µF; C_0805_2012Metric
C25, C26: 33pF; C_0805_2012Metric
F1: 3A; Fuse_1812_4532Metric
F2: MF-R500; C_1206_3216Metric
J3: Orange Pi Zero 3W - 40-Pin GPIO; PinHeader_2x20_P2.54mm_Vertical
J4: Conn_01x04_Pin; UPS_HAT_E_Mating
J5: ORANGE_PI_POWER_CABLE; PinHeader_1x04_P1.00mm_Vertical
J6: 5V_PERIPHERALS; PinHeader_1x02_P2.54mm_Vertical
Q2: 2N7002; SOT-23
R1: 10K; R_0805_2012Metric
R2, R6, R7, R24, R26: 100k; R_0805_2012Metric
R3: 22.1k; R_0805_2012Metric
R4: 1M; R_0805_2012Metric
R5: 12.0k; R_0805_2012Metric
R8, R9: 5.1k; R_0805_2012Metric
R10: 10 kΩ; R_0805_2012Metric
R11, R12, R13, R14, R15, R16, R17, R18, R19, R20, R21, R22, R23, R25, R27, R28: 10k; R_0805_2012Metric
U1: TPS54302DDCT; SOT-23-6

Connections:
+3V3_MAIN: C8.1, C11.1, C12.1, C13.1, C14.1, C15.1, C16.1, C17.1, C18.1, C20.1, C22.1, C23.1, C24.1, C28.1, R2.1, R10.1, R23.1
+5V_MAIN: C2.1, C3.1, C7.1, C9.1, C10.1, F1.1, F2.1, J4.4, J6.1, U1.3 (VIN), U1.5 (EN)
+5V_OPI: C4.1, C5.1, C6.1, F1.2, J5.1, R1.2
+5V_PPROTECTED: F2.2, R24.1
/SCL: J3.5, J4.2
/SDA: J3.3, J4.3
/USB/Q1-PIN1: Q2.3 (D), R24.2
/USB/RESET_N: C27.1, R10.2
/USB/VBUS_DET: R6.1, R7.2
/USB/XTAL1/CLKIN: C26.1, R4.1
/USB/XTAL2: C25.2, R4.2
/power/CC: J5.3, R1.1
/power/FB: C8.2, R2.2, R3.1, U1.4 (FB)
GND: C2.2, C3.2, C4.2, C5.2, C6.2, C7.2, C9.2, C10.2, C11.2, C12.2, C13.2, C14.2, C15.2, C16.2, C17.2, C18.2, C19.2, C20.2, C21.2, C22.2, C23.2, C24.2, C25.1, C26.2, C27.2, C28.2, J4.1, J5.2, J6.2, Q2.2 (S), R3.2, R5.1, R7.1, R8.2, R9.2, R11.2, R12.2, R13.2, R14.2, R15.2, R16.2, R17.2, R18.2, R19.2, R20.2, R21.1, R22.1, R26.1, R27.1, R28.1, U1.1 (GND)
unnamed: Q2.1 (G), R25.2, R26.2
unnamed: C1.1, U1.6 (BOOT)
unnamed: C1.2, U1.2 (SW)
