Oru-star/Doomsday-deck/Asstets/orangepi-zero3w-m2-carrier-main/orangepi-zero3w-m2-carrier-main/v1-passive-adapter/kicad files/zero3w.kicad_pcb

## KiCad design Asstets/orangepi-zero3w-m2-carrier-main/orangepi-zero3w-m2-carrier-main/v1-passive-adapter/kicad files/zero3w.kicad_pcb (2026-09-23)

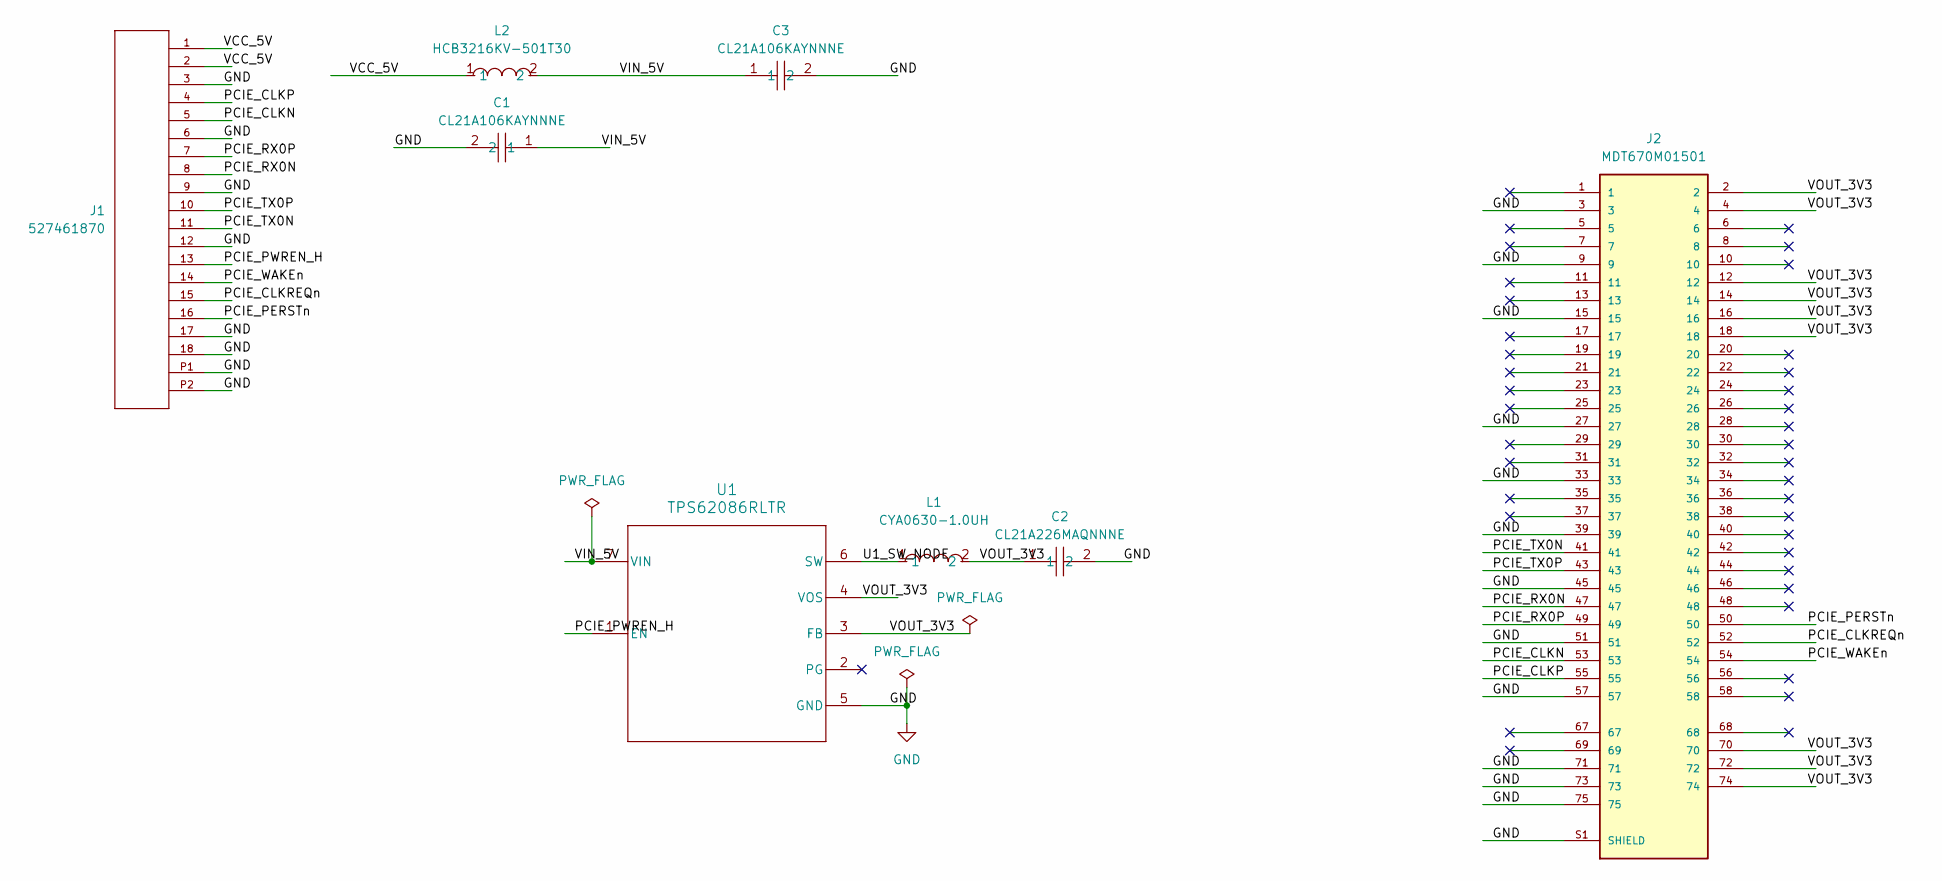
[picture p81: schematic zero3w.kicad_sch]

Parts:
C1, C3: CL21A106KAYNNNE; C0805; MPN CL21A106KAYNNNE; LCSC Part C15850
C2: CL21A226MAQNNNE; C0805; MPN CL21A226MAQNNNE; LCSC Part C45783
J1: 527461870; CON_527461870_MOL; MANUFACTURER_PART_NUMBER 527461870
J2: MDT670M01501; AMPHENOL_MDT670M01501; PARTREV 1
L1: CYA0630-1.0UH; IND-SMD_L7.2-W6.6_GPSR0730; MPN CYA0630-1.0UH; LCSC Part C5189744
L2: HCB3216KV-501T30; L1206; MPN HCB3216KV-501T30; LCSC Part C5139915
U1: TPS62086RLTR; RLT0007A

Connections:
/PCIE_CLKN: J1.5, J2.53
/PCIE_CLKP: J1.4, J2.55
/PCIE_CLKREQn: J1.15, J2.52
/PCIE_PERSTn: J1.16, J2.50
/PCIE_PWREN_H: J1.13, U1.1 (EN)
/PCIE_RX0N: J1.8, J2.47
/PCIE_RX0P: J1.7, J2.49
/PCIE_TX0N: J1.11, J2.41
/PCIE_TX0P: J1.10, J2.43
/PCIE_WAKEn: J1.14, J2.54
/U1_SW_NODE: L1.1, U1.6 (SW)
/VCC_5V: J1.1, J1.2, L2.1
/VIN_5V: C1.1, C3.1, L2.2, U1.7 (VIN)
/VOUT_3V3: C2.1, J2.2, J2.4, J2.12, J2.14, J2.16, J2.18, J2.70, J2.72, J2.74, L1.2, U1.3 (FB), U1.4 (VOS)
GND: C1.2, C2.2, C3.2, J1.3, J1.6, J1.9, J1.12, J1.17, J1.18, J1.P1, J1.P2, J2.3, J2.9, J2.15, J2.27, J2.33, J2.39, J2.45, J2.51, J2.57, J2.71, J2.73, J2.75, J2.S1 (SHIELD), J2.S2 (SHIELD), U1.5 (GND)

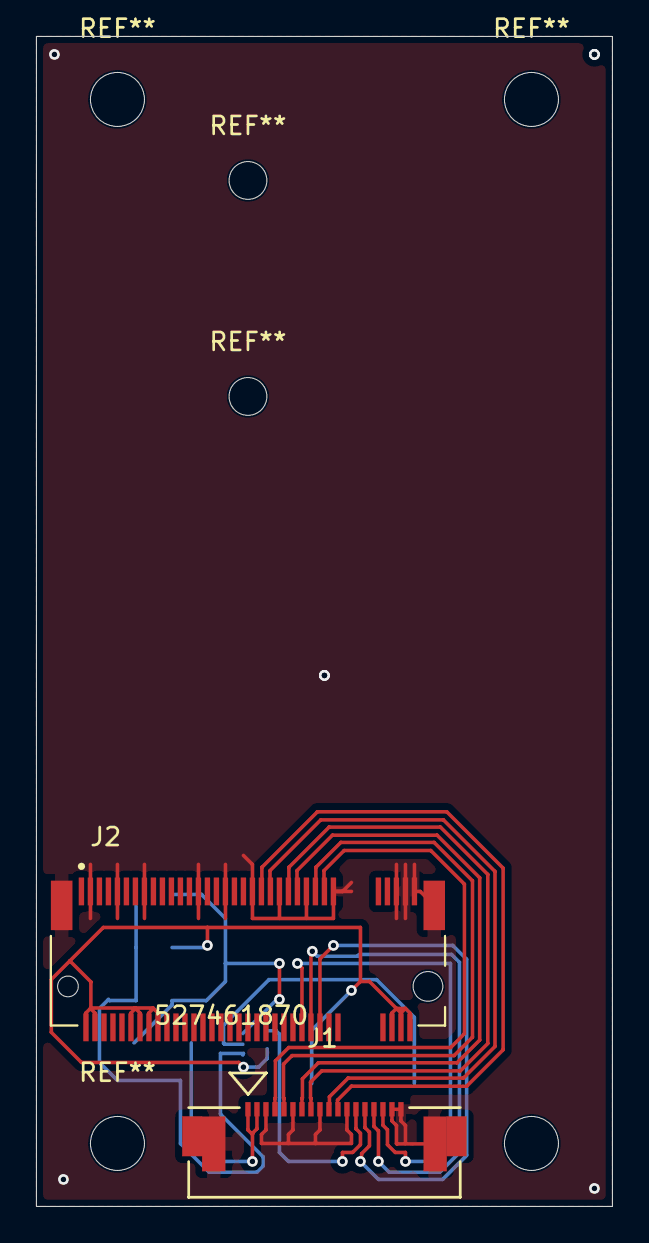
[picture p82: board zero3w.kicad_pcb from above]

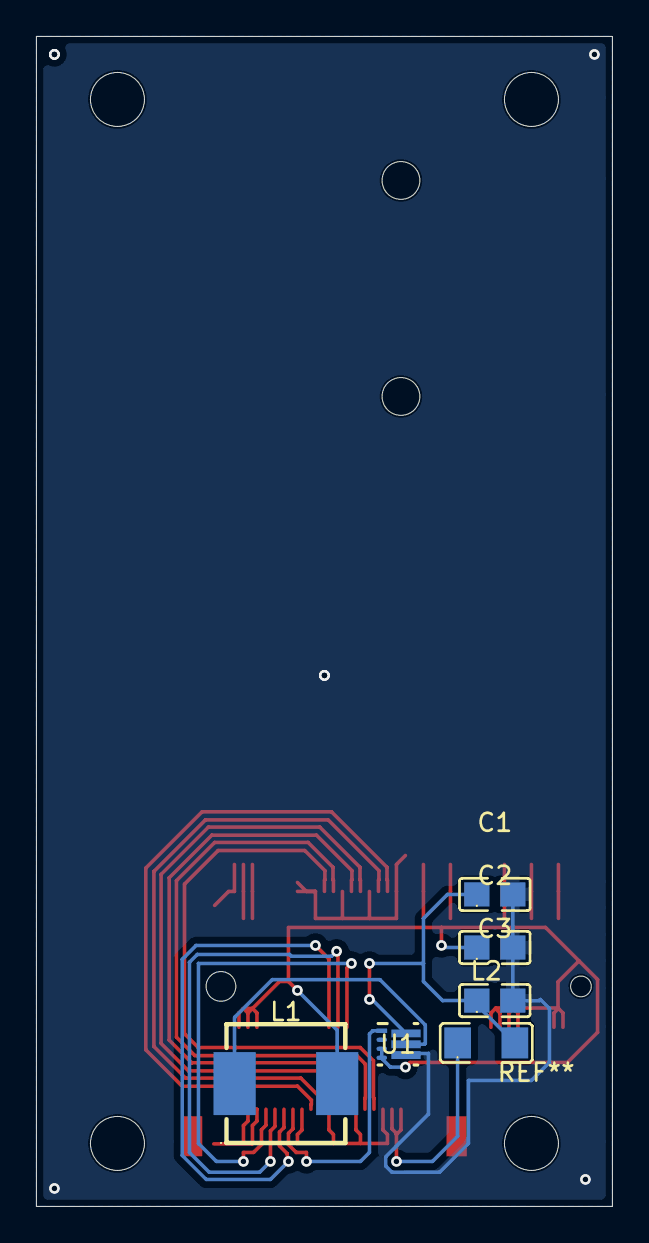
[picture p83: board zero3w.kicad_pcb from below]

Board: 2 copper layers, 32.0 x 65.0 mm, 8 parts (6 on the bottom side), 15 nets.
